nathanshaw/Parrot/README.md

# Parrot
Repo for housing everything Parrot Bot. A mechatronic creature which borrows rhythmic motifs from the sonic environment to playback on a host of actuators.
