nathanshaw/Parrot/pcb/eye_stocks/images/explorator_eye_stock_schematic.png

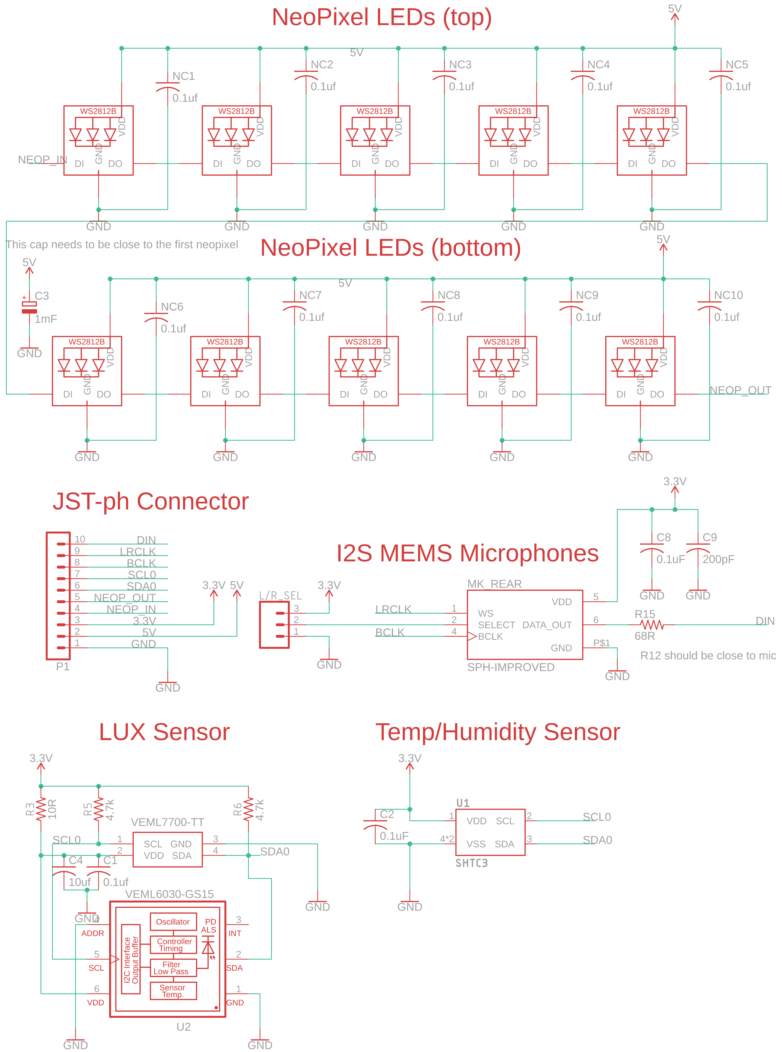
pcb/eye_stocks/images/explorator_eye_stock_schematic.png
