nathanshaw/Parrot/pcb/eye_stocks/images/explorator_eye_stock_v1_back_without_pour.png

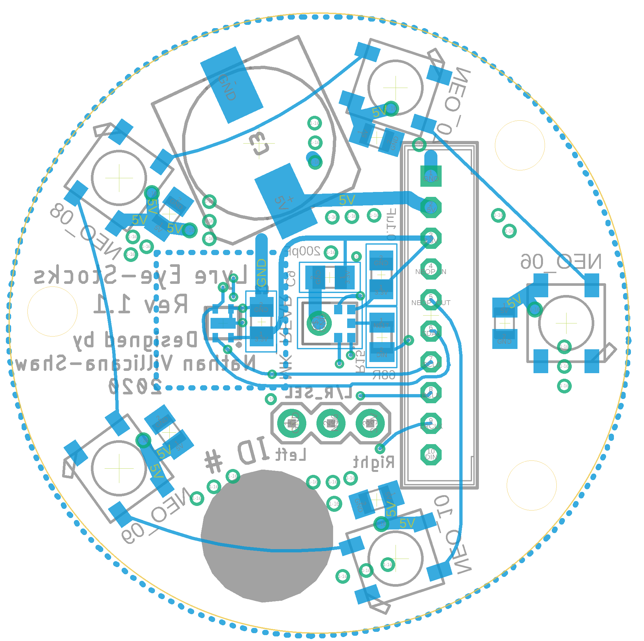
pcb/eye_stocks/images/explorator_eye_stock_v1_back_without_pour.png
