nathanshaw/Parrot/v1_images/parrot_back_with_pour.png

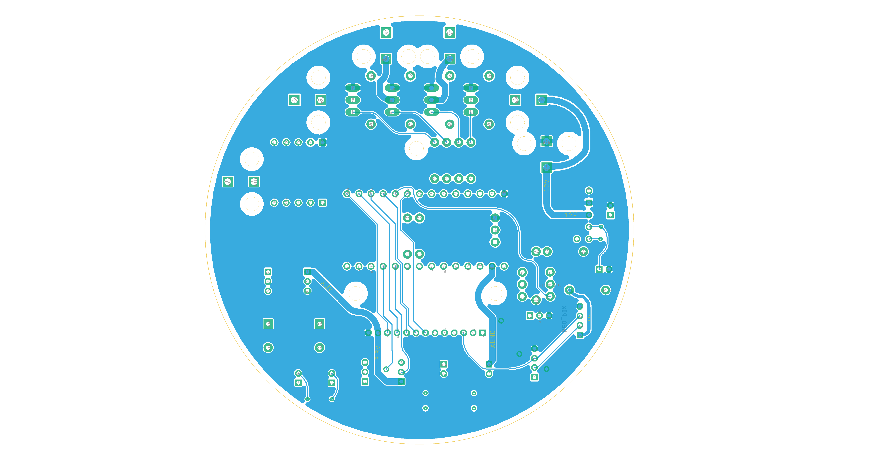
v1_images/parrot_back_with_pour.png
