nathanshaw/Parrot/v1_images/parrot_both_sides.png

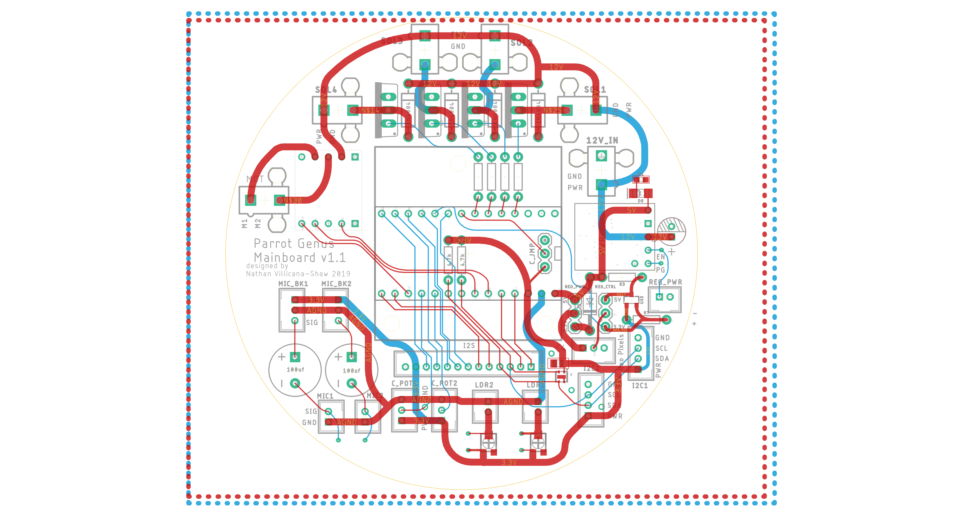
v1_images/parrot_both_sides.png
