nathanshaw/Parrot/legacy/Lyre_pictures/91280A702_MED-STRG ZINC-PLTD STL CAP SCREW - CLASS 8.8.STEP

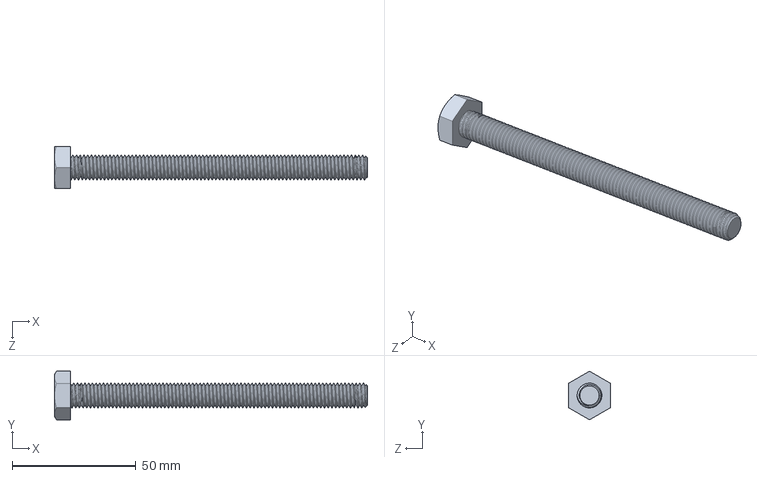
[picture p9: CAD file, 2020-02-04, an earlier design]
legacy/Lyre_pictures/91280A702_MED-STRG ZINC-PLTD STL CAP SCREW - CLASS 8.8.STEP
126.4 x 19.6 x 17.0 mm
