nathanshaw/Parrot/legacy/Lyre_pictures/94904A106_STAINLESS STEEL TEE NUT INSERT FOR WOOD.STEP

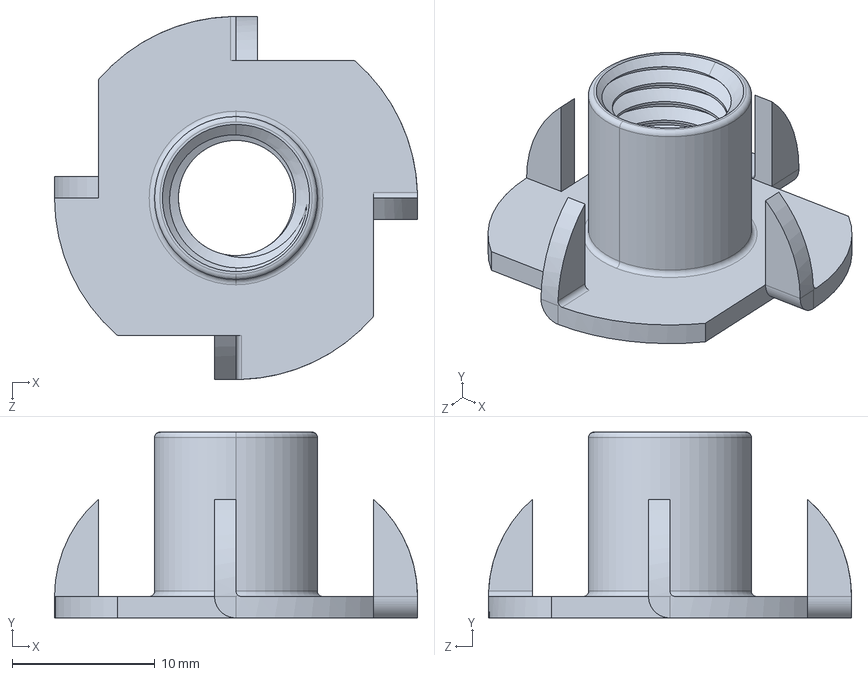
[picture p10: CAD file, 2020-02-04, an earlier design]
legacy/Lyre_pictures/94904A106_STAINLESS STEEL TEE NUT INSERT FOR WOOD.STEP
25.4 x 13.0 x 25.4 mm
