nathanshaw/Parrot/legacy/Lyre_pictures/90965A200_TYPE 316 STAINLESS STEEL FLAT WASHER.STEP

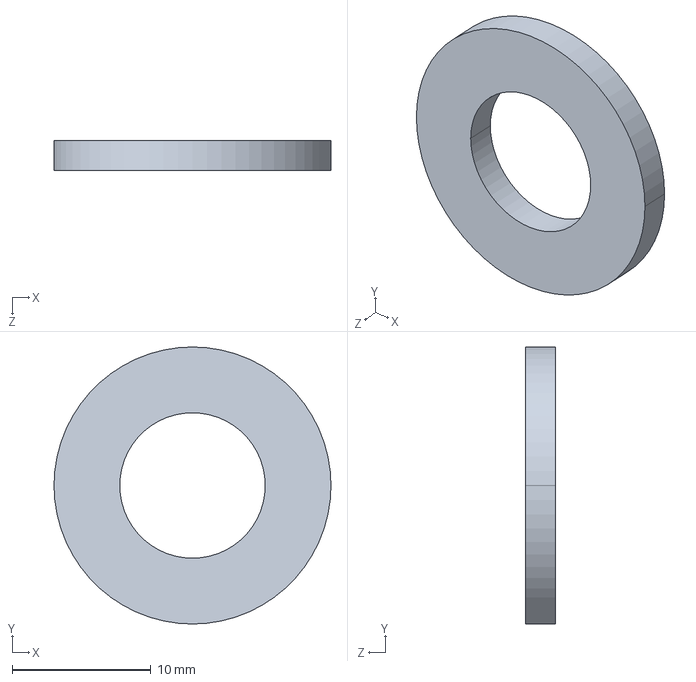
[picture p11: CAD file, 2020-02-04, an earlier design]
legacy/Lyre_pictures/90965A200_TYPE 316 STAINLESS STEEL FLAT WASHER.STEP
20.0 x 20.0 x 2.20 mm
