nathanshaw/Parrot/legacy/Lyre_pictures/Bowl Bot Order Request 2019_06_20 - Bowl Bot.pdf

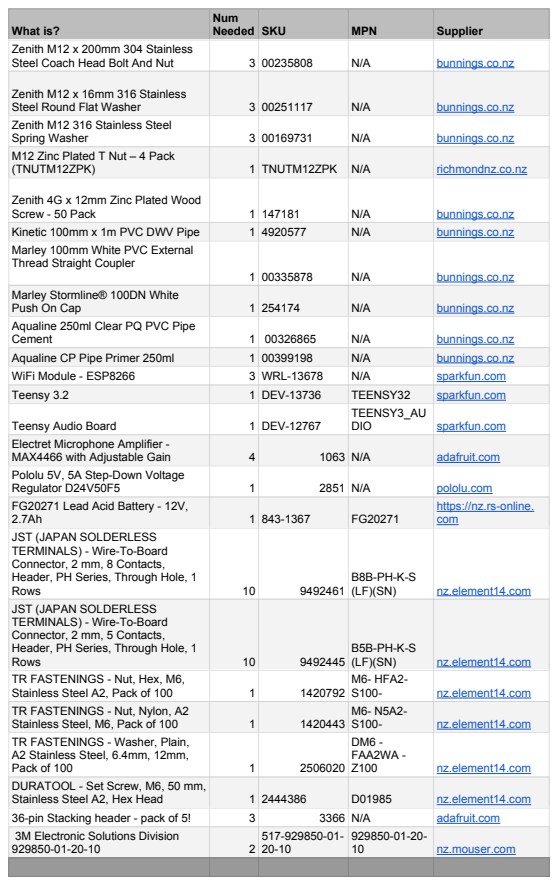
[picture p12: page 1]
What is?; Num; Needed SKU; MPN; Supplier; Zenith M12 x 200mm 304 Stainless; Steel Coach Head Bolt And Nut; bunnings.co.nz; Steel Round Flat Washer; Spring Washer; (TNUTM12ZPK); 1 TNUTM12ZPK; richmondnz.co.nz; Screw - 50 Pack; Kinetic 100mm x 1m PVC DWV Pipe; Push On Cap; Cement; Aqualine CP Pipe Primer 250ml; WiFi Module - ESP8266; 3 WRL-13678; sparkfun.com; Teensy 3.2; 1 DEV-13736; TEENSY32; Teensy Audio Board; 1 DEV-12767; TEENSY3_AU; DIO; MAX4466 with Adjustable Gain; adafruit.com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

Zenith M12 x 16mm 316 Stainless
Zenith M12 316 Stainless Steel
M12 Zinc Plated T Nut – 4 Pack

Zenith 4G x 12mm Zinc Plated Wood
Marley 100mm White PVC External
Thread Straight Coupler

Marley Stormline® 100DN White
Aqualine 250ml Clear PQ PVC Pipe

Electret Microphone Amplifier -
Pololu 5V, 5A Step-Down Voltage
FG20271 Lead Acid Battery - 12V,
JST (JAPAN SOLDERLESS
TERMINALS) - Wire-To-Board
Connector, 2 mm, 8 Contacts,
Header, PH Series, Through Hole, 1
Connector, 2 mm, 5 Contacts,
TR FASTENINGS - Nut, Hex, M6,
TR FASTENINGS - Nut, Nylon, A2
TR FASTENINGS - Washer, Plain,
A2 Stainless Steel, 6.4mm, 12mm,
DURATOOL - Set Screw, M6, 50 mm,
3M Electronic Solutions Division

https://nz.rs-online.
com (https://nz.rs-online.com)
