nathanshaw/Parrot/legacy/Lyre_pictures/Bowl-Bot v19 Drawing v2.pdf

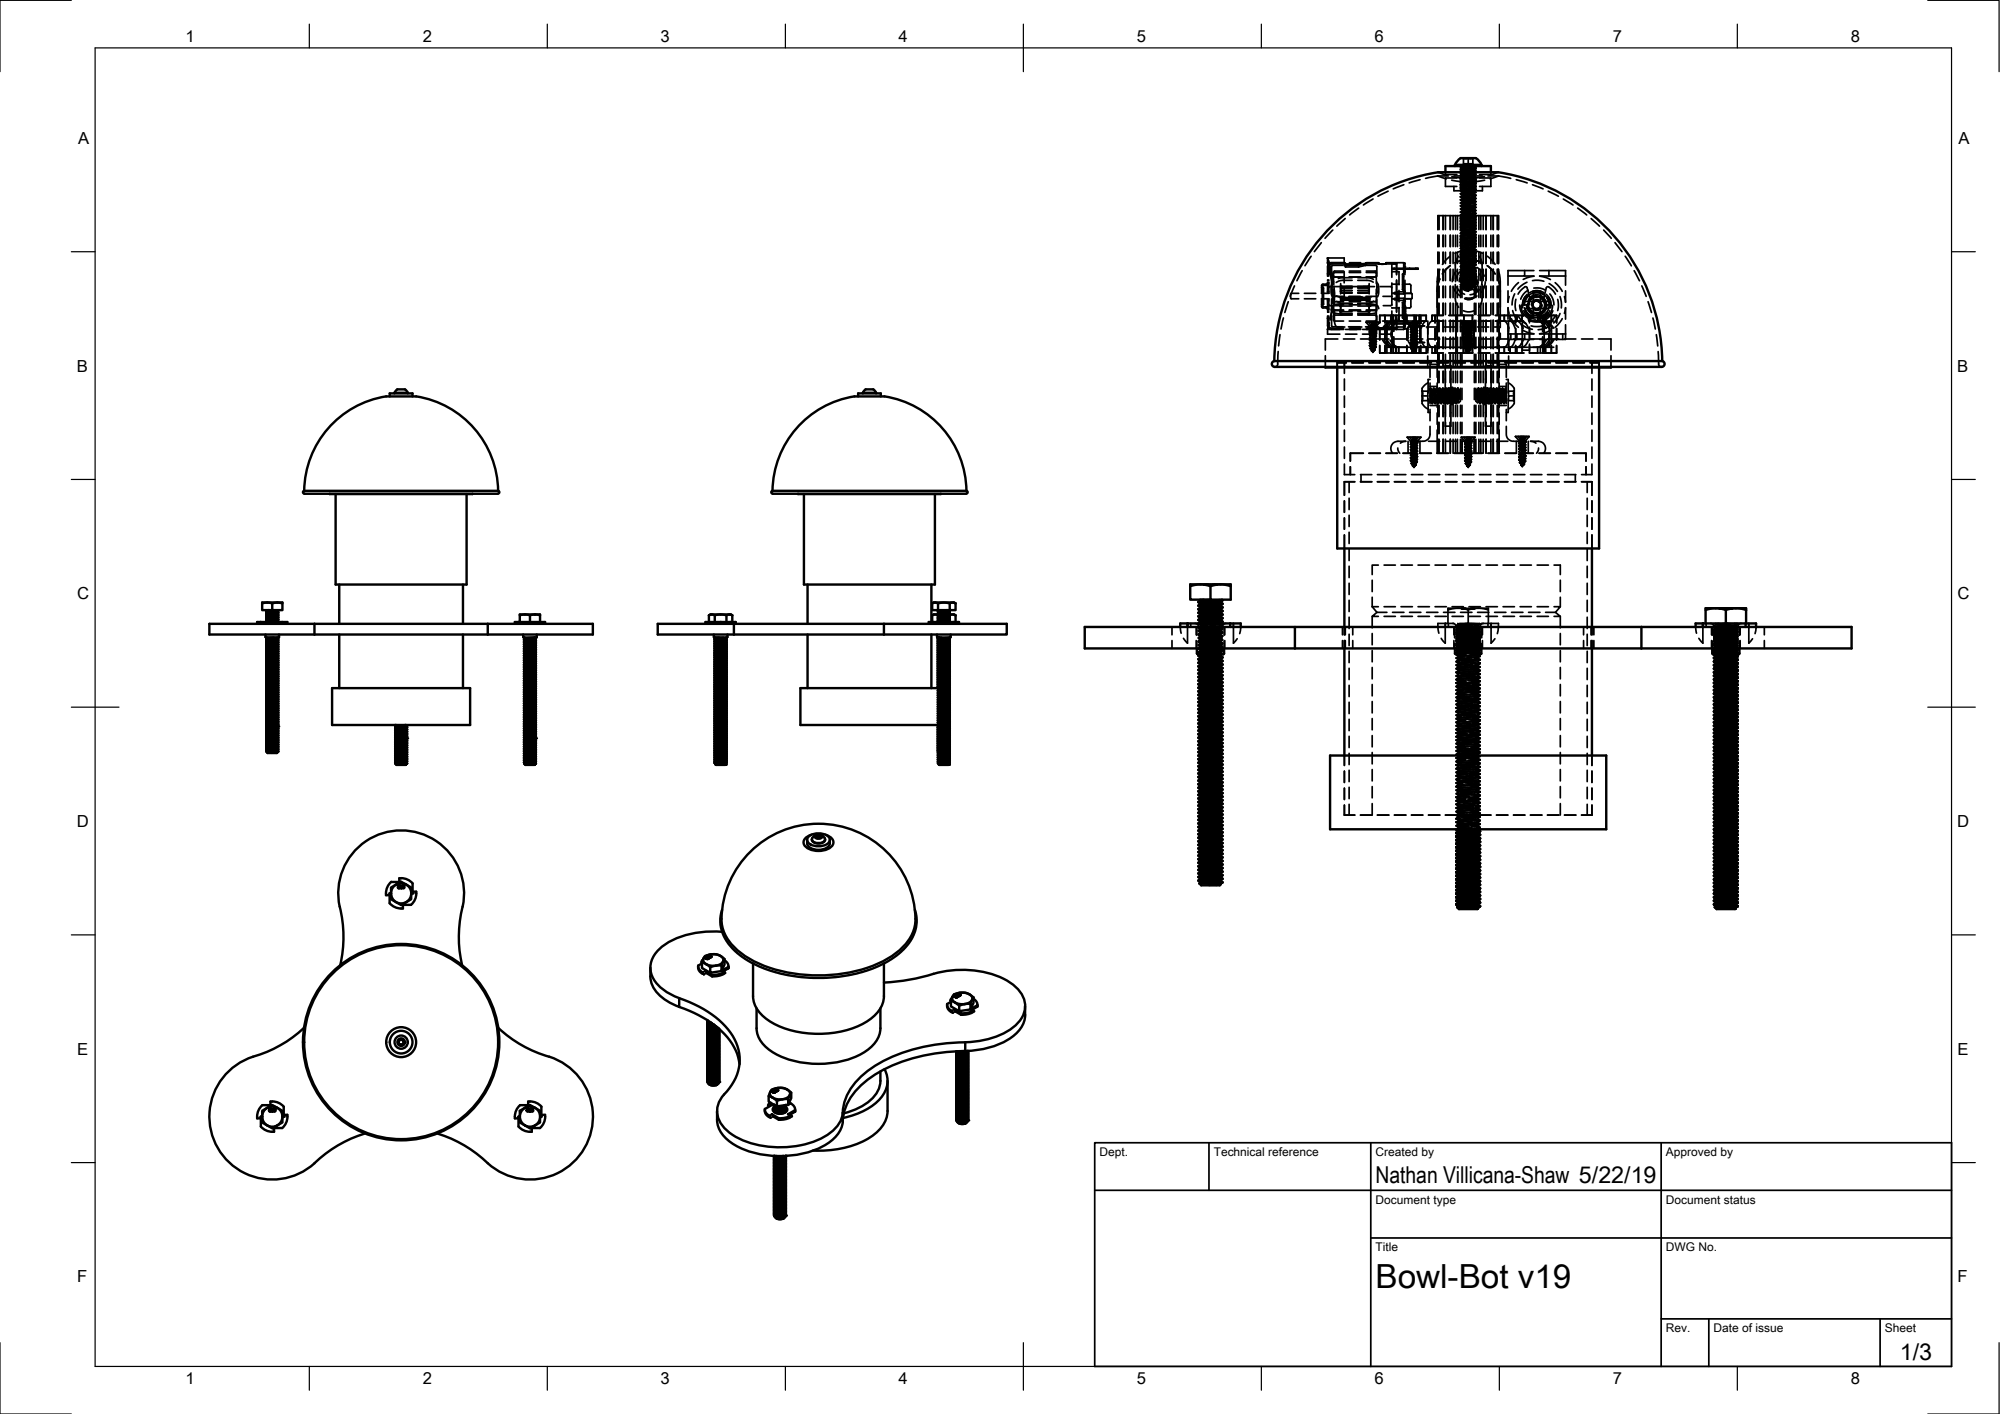
[picture p13: page 1]
Dept.; Technical reference; Created by; Approved by; Document type; Document status; Title; DWG No.; Rev.; Date of issue; Sheet; Bowl-Bot v19

Nathan Villicana-Shaw
