nathanshaw/Parrot/pcb/battery_pack/18500/18500_pack_v1.brd

## EAGLE design pcb/battery_pack/18500/18500_pack_v1.brd (2021-03-06)

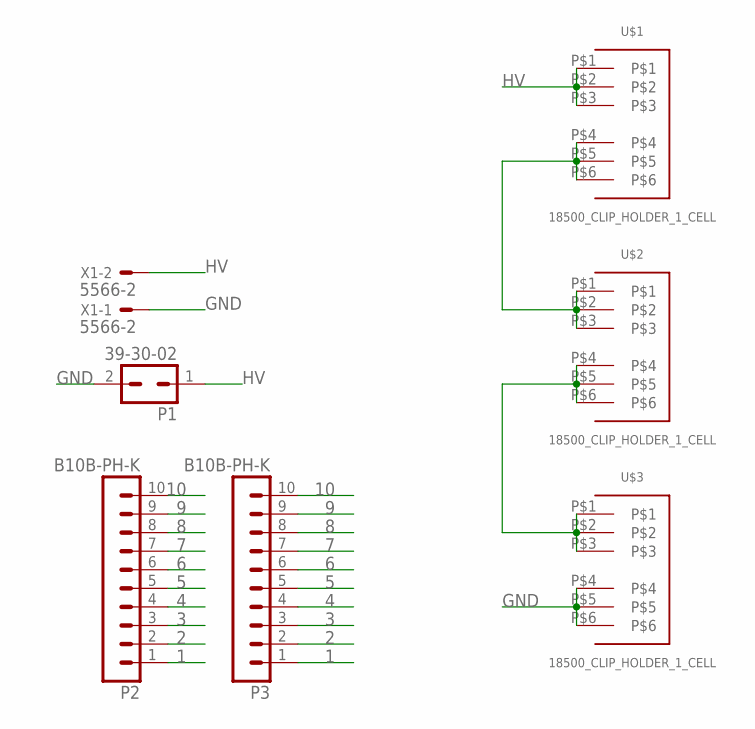
[picture p14: schematic 18500_pack_v1.sch]

Parts:
P1: 39-30-02; 39-30-?02?
P2, P3: B10B-PH-K
U$1, U$2, U$3: 18500_CLIP_HOLDER_1_CELL; 3PINBATTERY_CLIP_1_CELL_18500
X1: 5566-2

Connections:
1: P2.1, P3.1
2: P2.2, P3.2
3: P2.3, P3.3
4: P2.4, P3.4
5: P2.5, P3.5
6: P2.6, P3.6
7: P2.7, P3.7
8: P2.8, P3.8
9: P2.9, P3.9
10: P2.10, P3.10
GND: P1.2, U$3.P$4, U$3.P$5, U$3.P$6, X1.1
HV: P1.1, U$1.P$1, U$1.P$2, U$1.P$3, X1.2
unnamed: U$1.P$4, U$1.P$5, U$1.P$6, U$2.P$1, U$2.P$2, U$2.P$3
unnamed: U$2.P$4, U$2.P$5, U$2.P$6, U$3.P$1, U$3.P$2, U$3.P$3

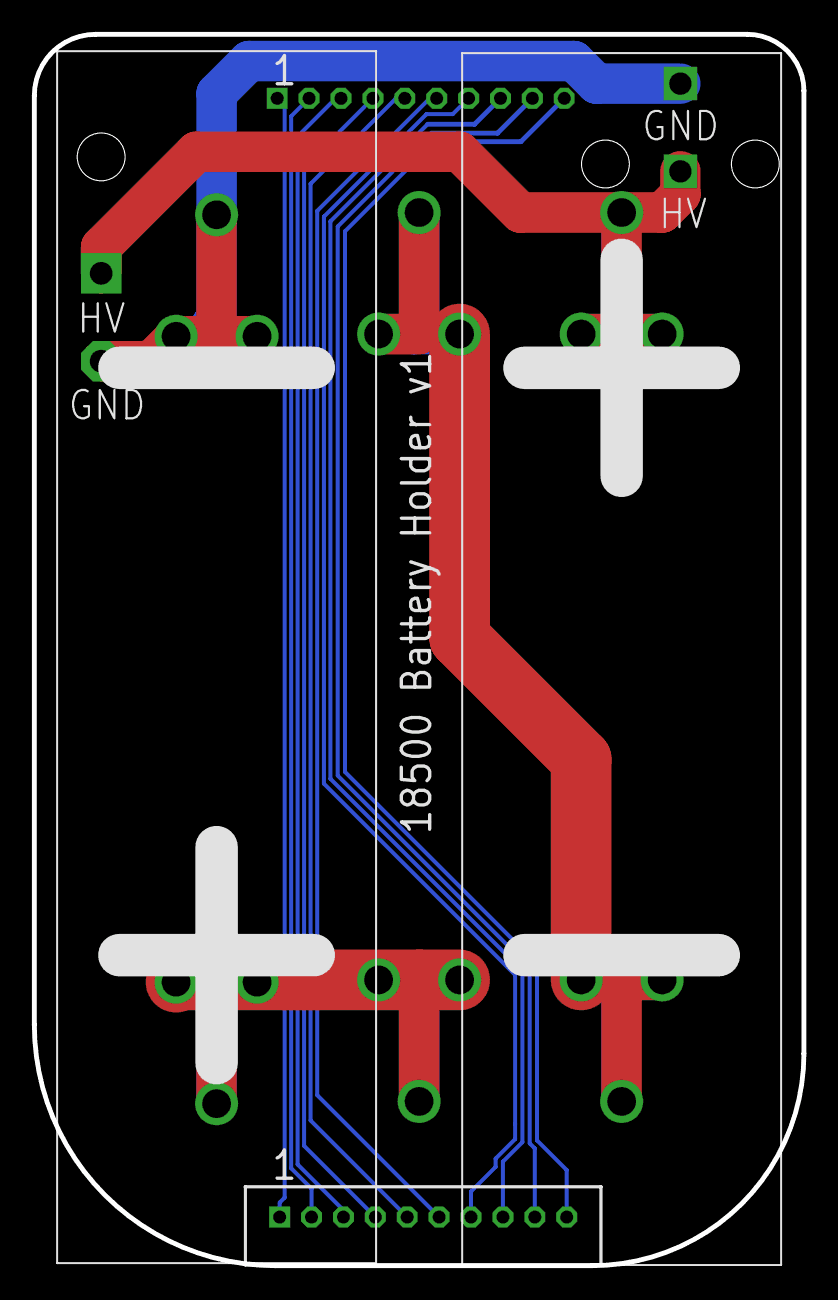
[picture p15: board 18500_pack_v1.brd from above]

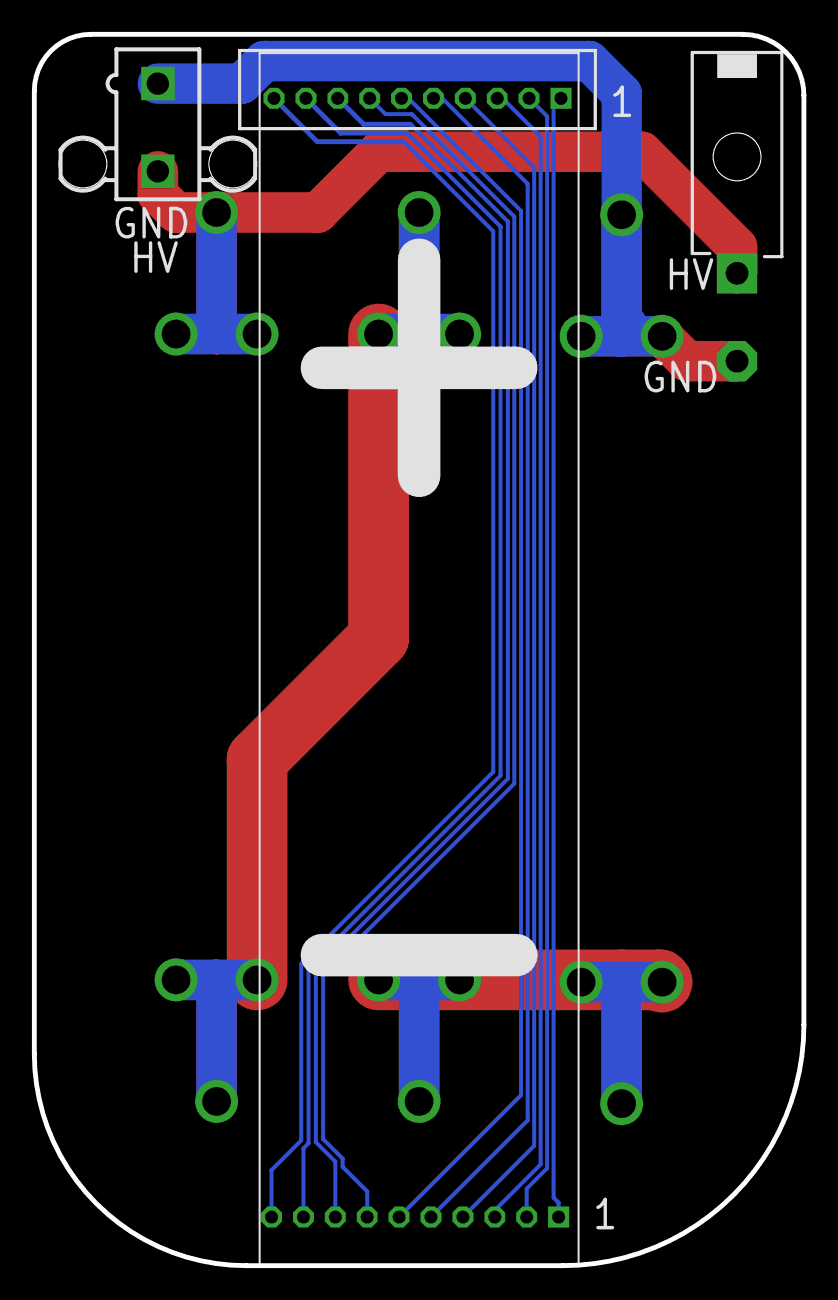
[picture p16: board 18500_pack_v1.brd from below]

Board: 2 copper layers, 48.3 x 77.2 mm, 7 parts (4 on the bottom side), 14 nets.
