nathanshaw/Parrot/pcb/v1/lyre_v1.brd

## EAGLE design pcb/v1/lyre_v1.brd (2021-03-06, an earlier design)

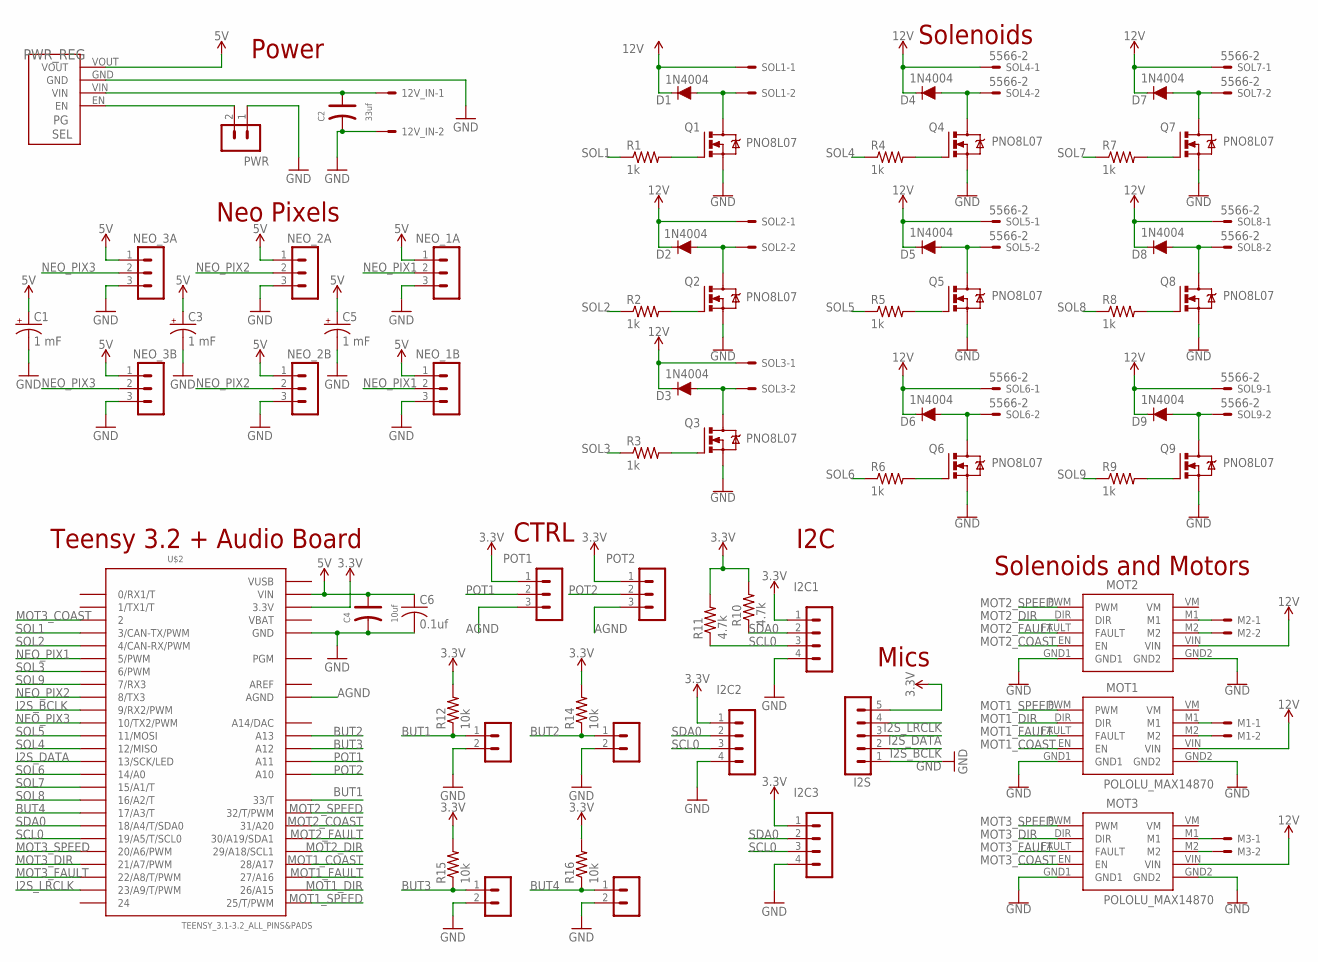
[picture p17: schematic lyre_v1.sch]

Parts:
12V_IN: 5566-2
BUT1, BUT2, BUT3, BUT4: B2B-PH-K
C1, C3, C5: 1 mF; UD-10X10_NICHICON
C2: 33uf; PC-D5.3MM
C4: 10uf; PC-D5.3MM
C6: 0.1uf; C2012
D1, D2, D3, D4, D5, D6, D7, D8, D9: 1N4004; DIOAD1138W86L465D235B
I2C1, I2C2, I2C3: B4B-PH-K
I2S: B5B-PH-K
M1, M2, M3: 5566-2
MOT1, MOT2, MOT3: POLOLU_MAX14870
NEO_1A, NEO_1B, NEO_2A, NEO_2B, NEO_3A, NEO_3B: B3B-PH-K
POT1, POT2: B3B-PH-K
PWR: B2B-PH-K
PWR_REG: S9V11F5S6CMA_MISSINIG_PINS; S9V11F3S5CMA_MISSING_PINS
Q1, Q2, Q3, Q4, Q5, Q6, Q7, Q8, Q9: PNO8L07; TO220BV
R1, R2, R3, R4, R5, R6, R7, R8, R9: 1k; R0805
R10, R11: 4.7k; R0805
R12, R14, R15, R16: 10k; R0805
SOL1, SOL2, SOL3, SOL4, SOL5, SOL6, SOL7, SOL8, SOL9: 5566-2
U$2: TEENSY_3.1-3.2_ALL_PINS&PADS; TEENSY_3.0-3.2_ALL_PINS_&_PADS

Connections:
3.3V: I2C1.1, I2C2.1, I2C3.1, I2S.5, POT1.1, POT2.1, R10.2, R11.2, R12.2, R14.2, R15.2, R16.2, U$2.3.3V, U$2.3.3V1 (3.3V), U$2.3.3V2 (3.3V)
5V: C1.+, C3.+, C4.+, C5.+, C6.1, NEO_1A.1, NEO_1B.1, NEO_2A.1, NEO_2B.1, NEO_3A.1, NEO_3B.1, PWR_REG.VOUT, U$2.VIN
12V: 12V_IN.1, C2.+, D1.2 (C), D2.2 (C), D3.2 (C), D4.2 (C), D5.2 (C), D6.2 (C), D7.2 (C), D8.2 (C), D9.2 (C), MOT1.VIN, MOT2.VIN, MOT3.VIN, PWR_REG.VIN, SOL1.1, SOL2.1, SOL3.1, SOL4.1, SOL5.1, SOL6.1, SOL7.1, SOL8.1, SOL9.1
AGND: POT1.3, POT2.3, U$2.AGND
AREF: U$2.AREF
BUT1: BUT1.1, R12.1, U$2.33 (33/T)
BUT2: BUT2.1, R14.1, U$2.A13
BUT3: BUT3.1, R15.1, U$2.A12
BUT4: BUT4.1, R16.1, U$2.17/A3 (17/A3/T)
GND: 12V_IN.2, BUT1.2, BUT2.2, BUT3.2, BUT4.2, C1.-, C2.-, C3.-, C4.-, C5.-, C6.2, I2C1.4, I2C2.4, I2C3.4, I2S.1, MOT1.GND1, MOT1.GND2, MOT2.GND1, MOT2.GND2, MOT3.GND1, MOT3.GND2, NEO_1A.3, NEO_1B.3, NEO_2A.3, NEO_2B.3, NEO_3A.3, NEO_3B.3, PWR.1, PWR_REG.GND, Q1.S, Q2.S, Q3.S, Q4.S, Q5.S, Q6.S, Q7.S, Q8.S, Q9.S, U$2.GND, U$2.GND1 (GND), U$2.GND2 (GND)
I2S_BCLK: I2S.2, U$2.9 (9/RX2/PWM)
I2S_DATA: I2S.3, U$2.13 (13/SCK/LED)
I2S_LRCLK: I2S.4, U$2.23/A9 (23/A9/T/PWM)
MOT1_COAST: MOT1.EN, U$2.28 (28/A17)
MOT1_DIR: MOT1.DIR, U$2.26 (26/A15)
MOT1_FAULT: MOT1.FAULT, U$2.27 (27/A16)
MOT1_SPEED: MOT1.PWM, U$2.25 (25/T/PWM)
MOT2_COAST: MOT2.EN, U$2.31 (31/A20)
MOT2_DIR: MOT2.DIR, U$2.29 (29/A18/SCL1)
MOT2_FAULT: MOT2.FAULT, U$2.30 (30/A19/SDA1)
MOT2_SPEED: MOT2.PWM, U$2.32 (32/T/PWM)
MOT3_COAST: MOT3.EN, U$2.2
MOT3_DIR: MOT3.DIR, U$2.21/A7 (21/A7/PWM)
MOT3_FAULT: MOT3.FAULT, U$2.22/A8 (22/A8/T/PWM)
MOT3_SPEED: MOT3.PWM, U$2.20/A6 (20/A6/PWM)
unnamed: Q5.G, R5.2
unnamed: D5.1 (A), Q5.D, SOL5.2
unnamed: M1.2, MOT1.M2
unnamed: Q6.G, R6.2
unnamed: Q2.G, R2.2
unnamed: D6.1 (A), Q6.D, SOL6.2
unnamed: D2.1 (A), Q2.D, SOL2.2
unnamed: M1.1, MOT1.M1
unnamed: PWR.2, PWR_REG.EN
unnamed: Q3.G, R3.2
unnamed: D3.1 (A), Q3.D, SOL3.2
unnamed: Q4.G, R4.2
unnamed: D4.1 (A), Q4.D, SOL4.2
unnamed: M3.2, MOT3.M2
unnamed: M3.1, MOT3.M1
unnamed: Q7.G, R7.2
unnamed: D7.1 (A), Q7.D, SOL7.2
unnamed: Q8.G, R8.2
unnamed: D8.1 (A), Q8.D, SOL8.2
unnamed: Q9.G, R9.2
unnamed: D9.1 (A), Q9.D, SOL9.2
unnamed: Q1.G, R1.2
unnamed: D1.1 (A), Q1.D, SOL1.2
unnamed: M2.2, MOT2.M2
unnamed: M2.1, MOT2.M1
NEO_PIX1: NEO_1A.2, NEO_1B.2, U$2.5 (5/PWM)
NEO_PIX2: NEO_2A.2, NEO_2B.2, U$2.8 (8/TX3)
NEO_PIX3: NEO_3A.2, NEO_3B.2, U$2.10 (10/TX2/PWM)
POT1: POT1.2, U$2.A11
POT2: POT2.2, U$2.A10
SCL0: I2C1.3, I2C2.3, I2C3.3, R11.1, U$2.19/A5 (19/A5/T/SCL0)
SDA0: I2C1.2, I2C2.2, I2C3.2, R10.1, U$2.18/A4 (18/A4/T/SDA0)
SOL1: R1.1, U$2.3 (3/CAN-TX/PWM)
SOL2: R2.1, U$2.4 (4/CAN-RX/PWM)
SOL3: R3.1, U$2.6 (6/PWM)
SOL4: R4.1, U$2.12 (12/MISO)
SOL5: R5.1, U$2.11 (11/MOSI)
SOL6: R6.1, U$2.14/A0
SOL7: R7.1, U$2.15/A1 (15/A1/T)
SOL8: R8.1, U$2.16/A2 (16/A2/T)
SOL9: R9.1, U$2.7 (7/RX3)
VBAT: U$2.VBAT
VUSB: U$2.VUSB

Notes on the sheet:
Neo Pixels
I2C
Solenoids and Motors
Teensy 3.2 + Audio Board
Mics
Power
CTRL
Solenoids

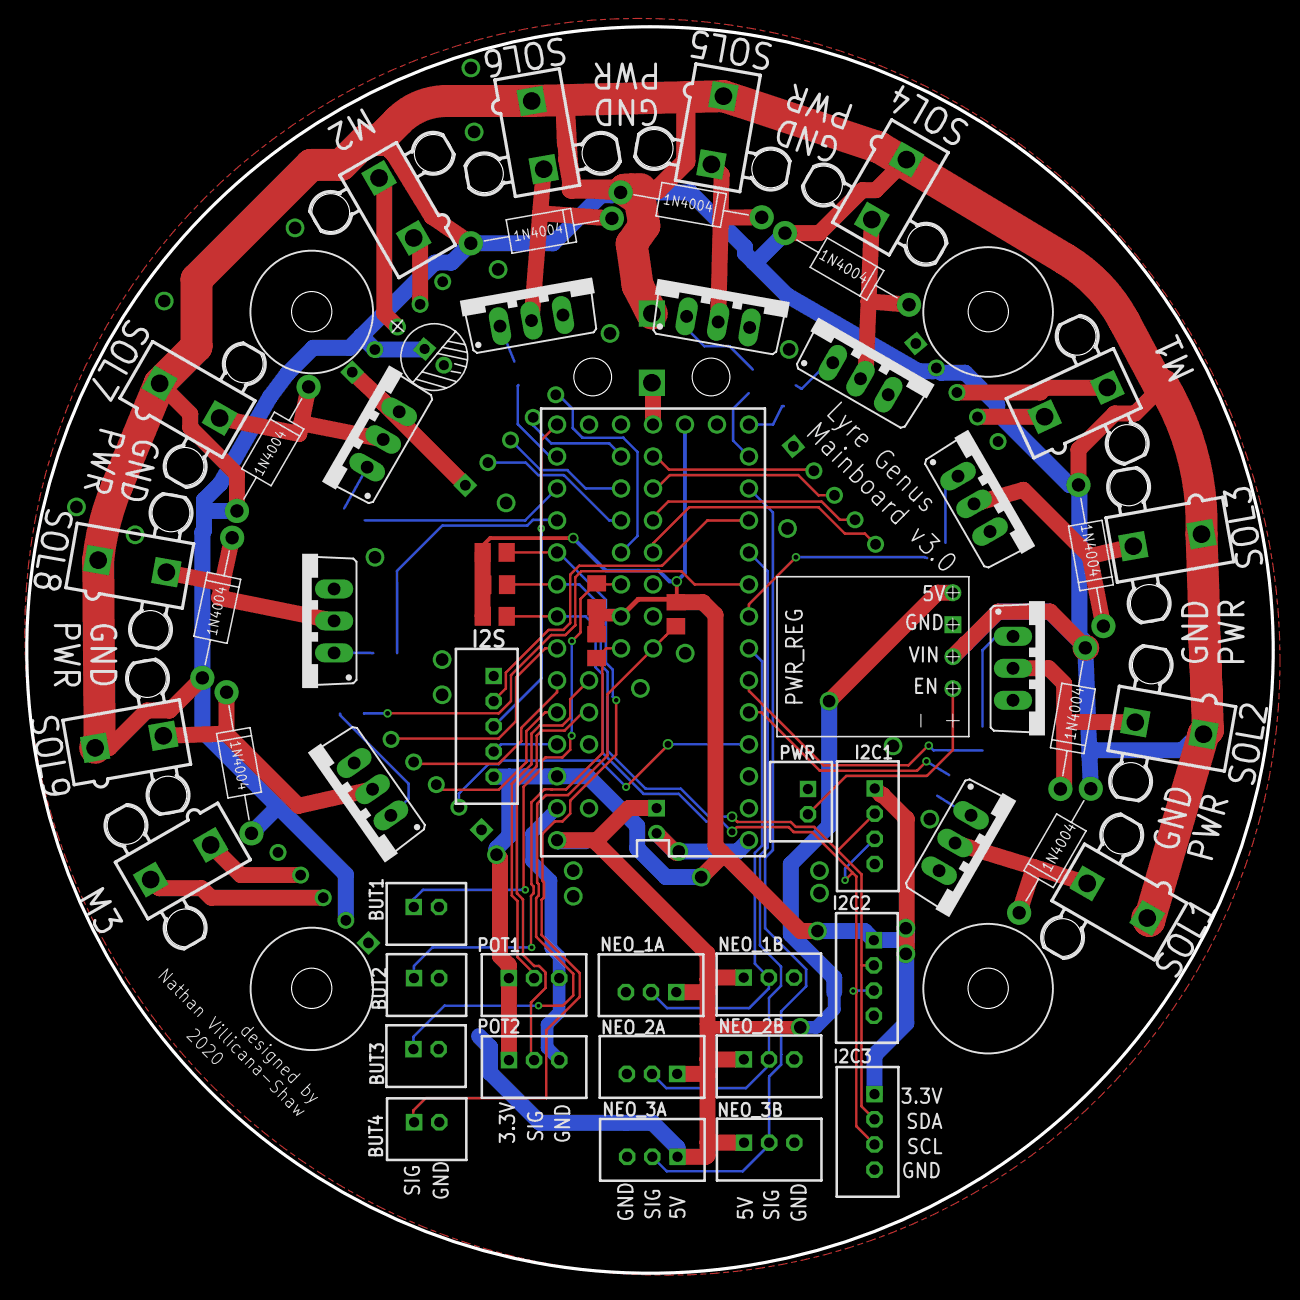
[picture p18: board lyre_v1.brd from above]

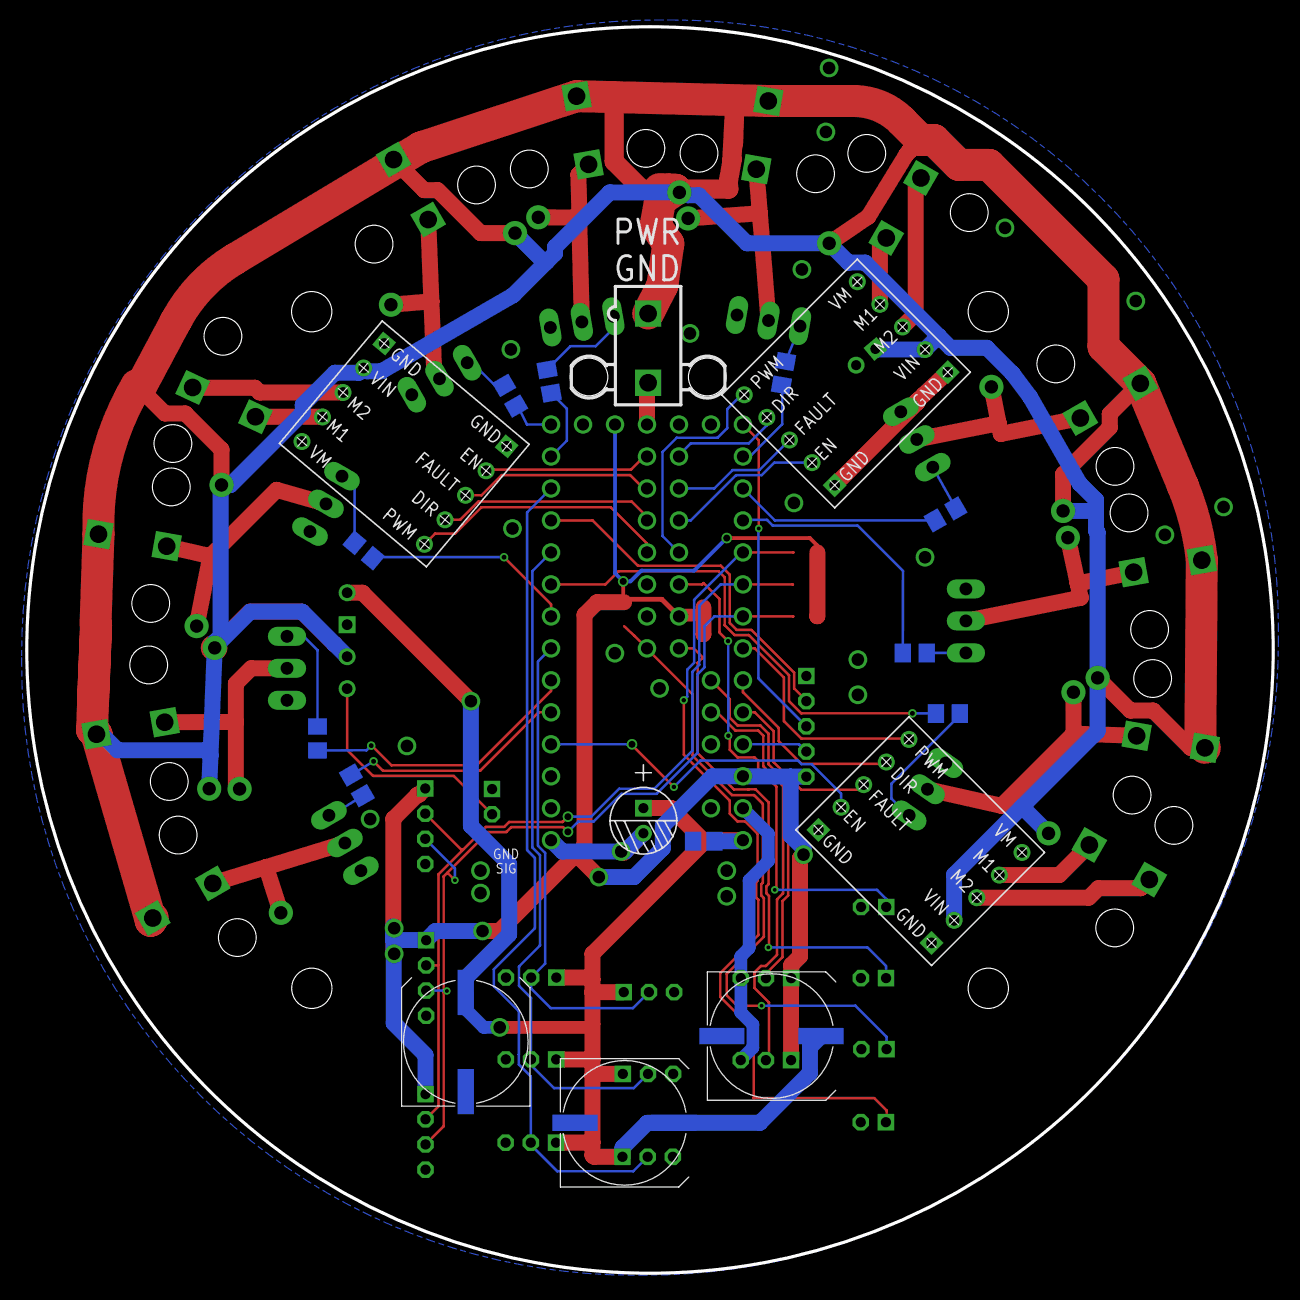
[picture p19: board lyre_v1.brd from below]

Board: 2 copper layers, 99.0 x 99.0 mm, 74 parts (18 on the bottom side), 65 nets.
