nathanshaw/Parrot/pcb/eye_stocks/lyre_eye_stocks_40mm_breakout.brd

## EAGLE design pcb/eye_stocks/lyre_eye_stocks_40mm_breakout.brd (2021-03-06)

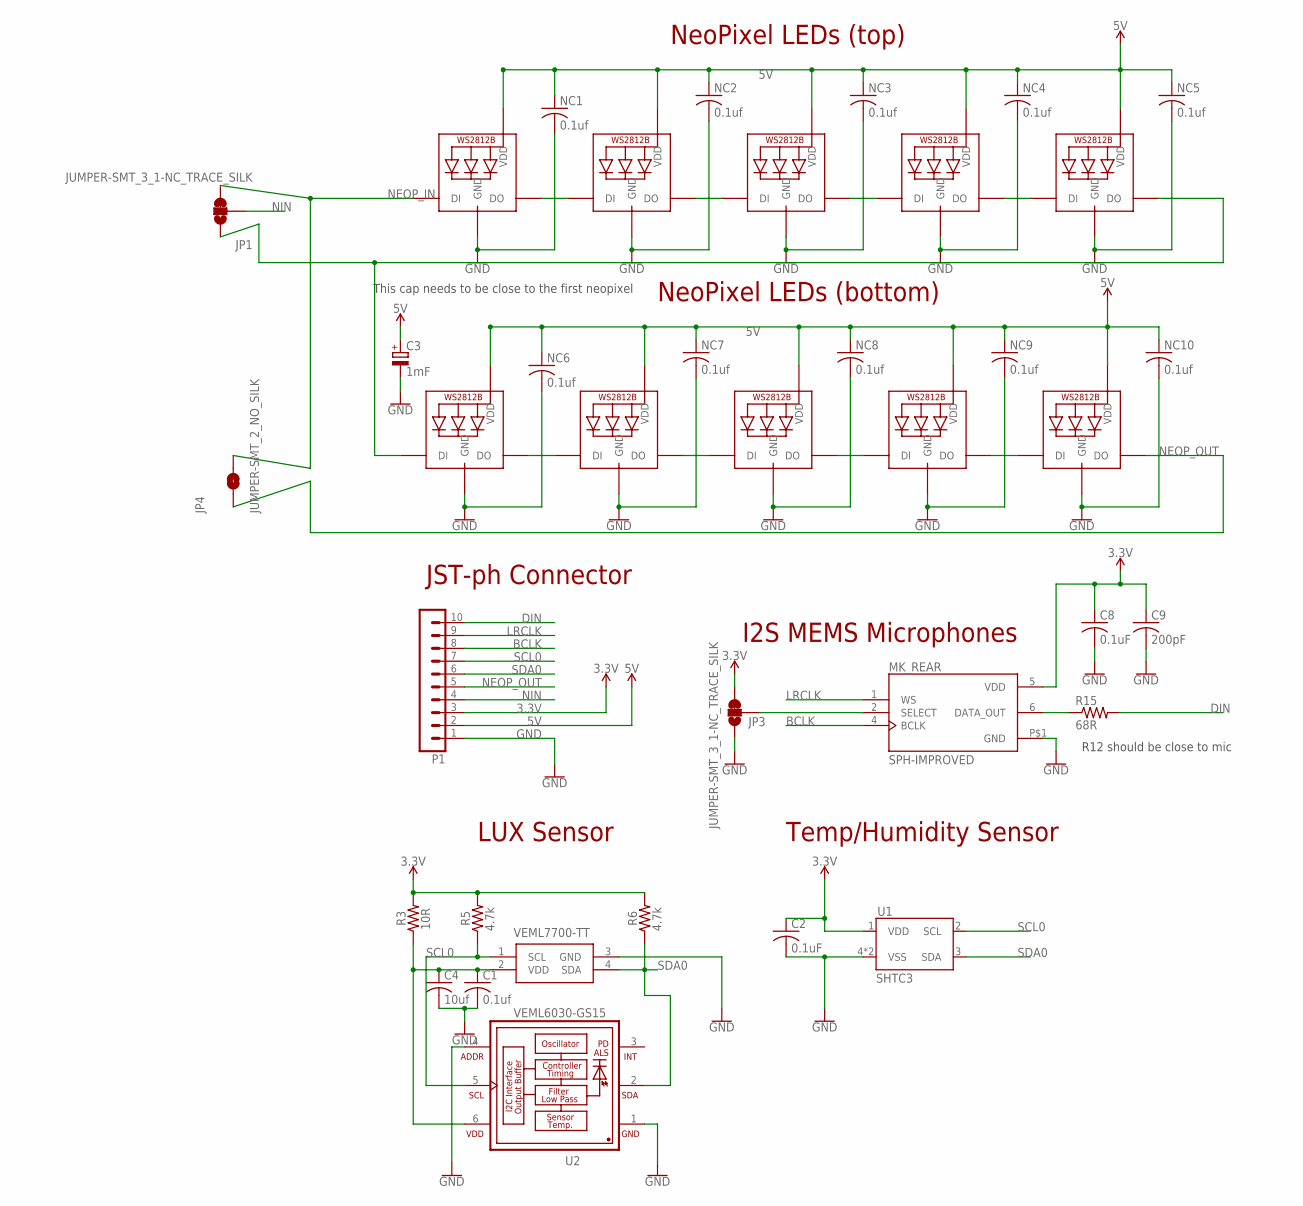
[picture p20: schematic lyre_eye_stocks_40mm_breakout.sch]

Parts:
C1: 0.1uf; C0805
C2, C8: 0.1uF; C0805
C3: 1mF; 153CLV-1012
C4: 10uf; C0805
C9: 200pF; C0805
JP1, JP3: JUMPER-SMT_3_1-NC_TRACE_SILK; SMT-JUMPER_3_1-NC_TRACE_SILK
JP4: JUMPER-SMT_2_NO_SILK; SMT-JUMPER_2_NO_SILK
MK_REAR: SPH-IMPROVED; MIC_SPH0645LM4H-B_LARGER_RING
NC1, NC2, NC3, NC4, NC5, NC6, NC7, NC8, NC9, NC10: 0.1uf; C0805
NEO_01, NEO_02, NEO_03, NEO_04, NEO_05, NEO_06, NEO_07, NEO_08, NEO_09, NEO_10: WS2812; WS2812B
P1: B10B-PH-K
R3: 10R; R0805
R5, R6: 4.7k; R0805
R15: 68R; R0805
U1: SHTC3
U2: VEML6030-GS15; VISHAY_VEML6030_2X2X0.87
VEML_F: VEML7700-TT; VEML7700

Connections:
3.3V: C2.1, C8.1, C9.1, JP3.3, MK_REAR.5 (VDD), P1.3, R3.2, R5.2, R6.2, U1.1 (VDD)
5V: C3.+, NC1.1, NC2.1, NC3.1, NC4.1, NC5.1, NC6.1, NC7.1, NC8.1, NC9.1, NC10.1, NEO_01.1-VDD (VDD), NEO_02.1-VDD (VDD), NEO_03.1-VDD (VDD), NEO_04.1-VDD (VDD), NEO_05.1-VDD (VDD), NEO_06.1-VDD (VDD), NEO_07.1-VDD (VDD), NEO_08.1-VDD (VDD), NEO_09.1-VDD (VDD), NEO_10.1-VDD (VDD), P1.2
BCLK: MK_REAR.4 (BCLK), P1.8
DIN: P1.10, R15.2
GND: C1.2, C2.2, C3.-, C4.2, C8.2, C9.2, JP3.1, MK_REAR.P$1 (GND), NC1.2, NC2.2, NC3.2, NC4.2, NC5.2, NC6.2, NC7.2, NC8.2, NC9.2, NC10.2, NEO_01.3-GND (GND), NEO_02.3-GND (GND), NEO_03.3-GND (GND), NEO_04.3-GND (GND), NEO_05.3-GND (GND), NEO_06.3-GND (GND), NEO_07.3-GND (GND), NEO_08.3-GND (GND), NEO_09.3-GND (GND), NEO_10.3-GND (GND), P1.1, U1.4 (VSS), U1.5 (VSS), U2.1 (GND), U2.4 (ADDR), VEML_F.3 (GND)
LRCLK: MK_REAR.1 (WS), P1.9
unnamed: C1.1, C4.1, R3.1, U2.6 (VDD), VEML_F.2 (VDD)
unnamed: JP1.1, NEO_05.2-DOUT (DO), NEO_06.4-DIN (DI)
unnamed: NEO_02.2-DOUT (DO), NEO_03.4-DIN (DI)
unnamed: NEO_09.2-DOUT (DO), NEO_10.4-DIN (DI)
unnamed: JP3.2, MK_REAR.2 (SELECT)
unnamed: NEO_07.2-DOUT (DO), NEO_08.4-DIN (DI)
unnamed: NEO_04.2-DOUT (DO), NEO_05.4-DIN (DI)
unnamed: NEO_08.2-DOUT (DO), NEO_09.4-DIN (DI)
unnamed: NEO_03.2-DOUT (DO), NEO_04.4-DIN (DI)
unnamed: MK_REAR.6 (DATA_OUT), R15.1
NEOP_IN: JP1.3, JP4.2, NEO_01.4-DIN (DI)
NEOP_OUT: JP4.1, NEO_10.2-DOUT (DO), P1.5
NEO_P1: NEO_01.2-DOUT (DO), NEO_02.4-DIN (DI)
NEO_P2: NEO_06.2-DOUT (DO), NEO_07.4-DIN (DI)
NIN: JP1.2, P1.4
SCL0: P1.7, R5.1, U1.2 (SCL), U2.5 (SCL), VEML_F.1 (SCL)
SDA0: P1.6, R6.1, U1.3 (SDA), U2.2 (SDA), VEML_F.4 (SDA)

Notes on the sheet:
I2S MEMS Microphones
LUX Sensor
NeoPixel LEDs (top)
4.7k
R12 should be close to mic
10R
This cap needs to be close to the first neopixel
Temp/Humidity Sensor
NeoPixel LEDs (bottom)
JST-ph Connector

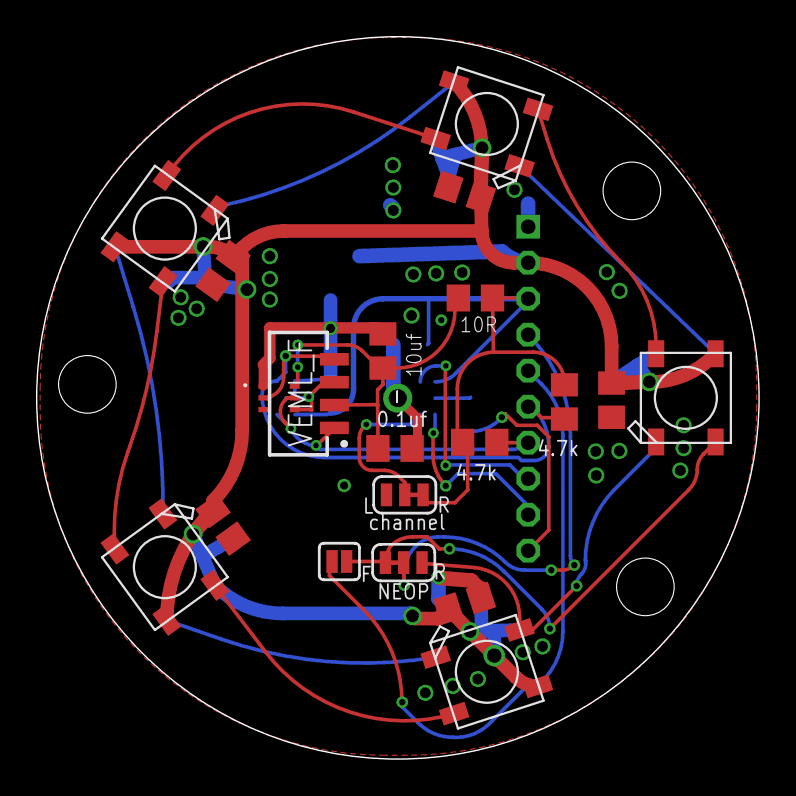
[picture p21: board lyre_eye_stocks_40mm_breakout.brd from above]

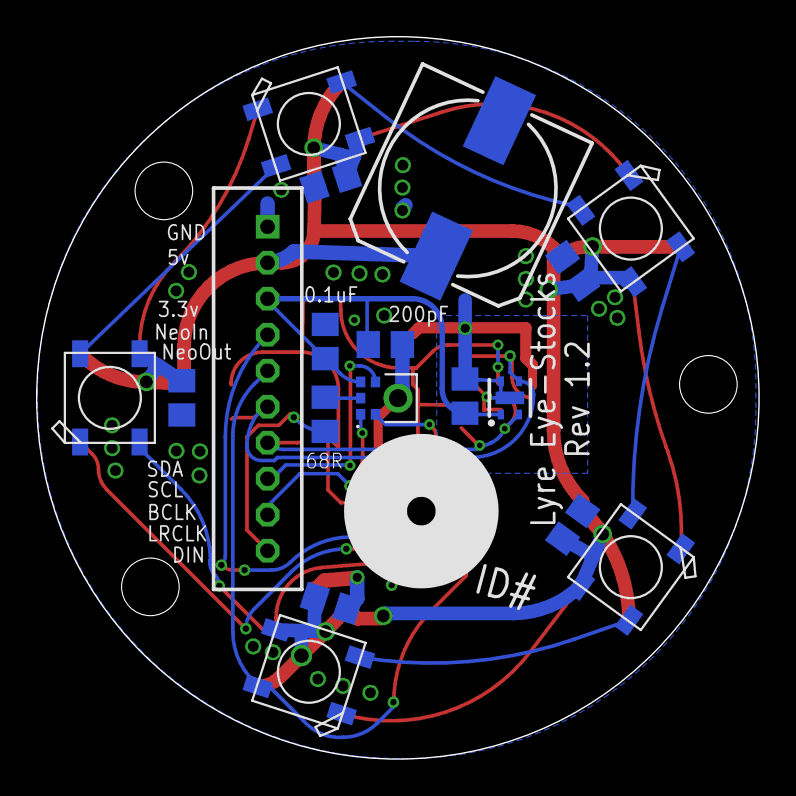
[picture p22: board lyre_eye_stocks_40mm_breakout.brd from below]

Board: 2 copper layers, 40.1 x 40.1 mm, 38 parts (18 on the bottom side), 23 nets.
