nathanshaw/Parrot/pcb/small_pcb_v1/small_pcb_explorator_58mm_lyre_v1_1.brd

## EAGLE design pcb/small_pcb_v1/small_pcb_explorator_58mm_lyre_v1_1.brd (2021-03-06)

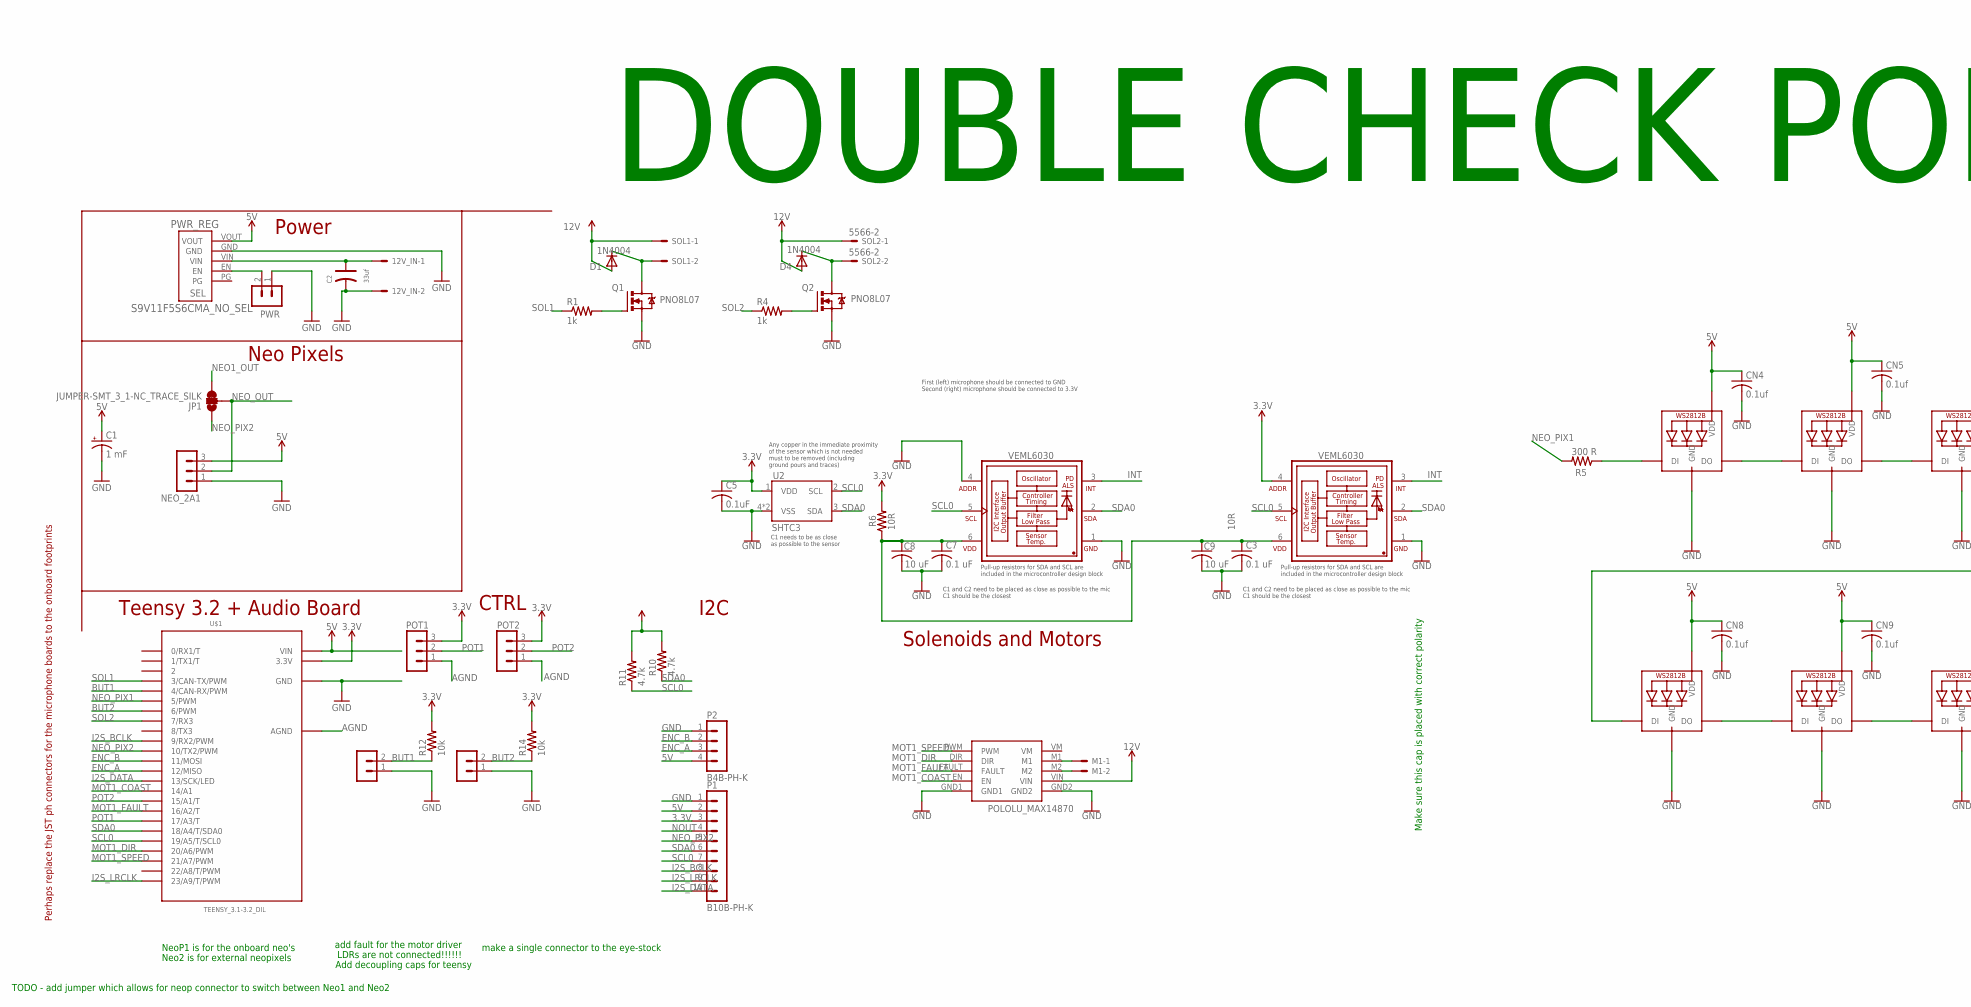
[picture p23: schematic small_pcb_explorator_58mm_lyre_v1_1.sch, part in row 1, column 1]

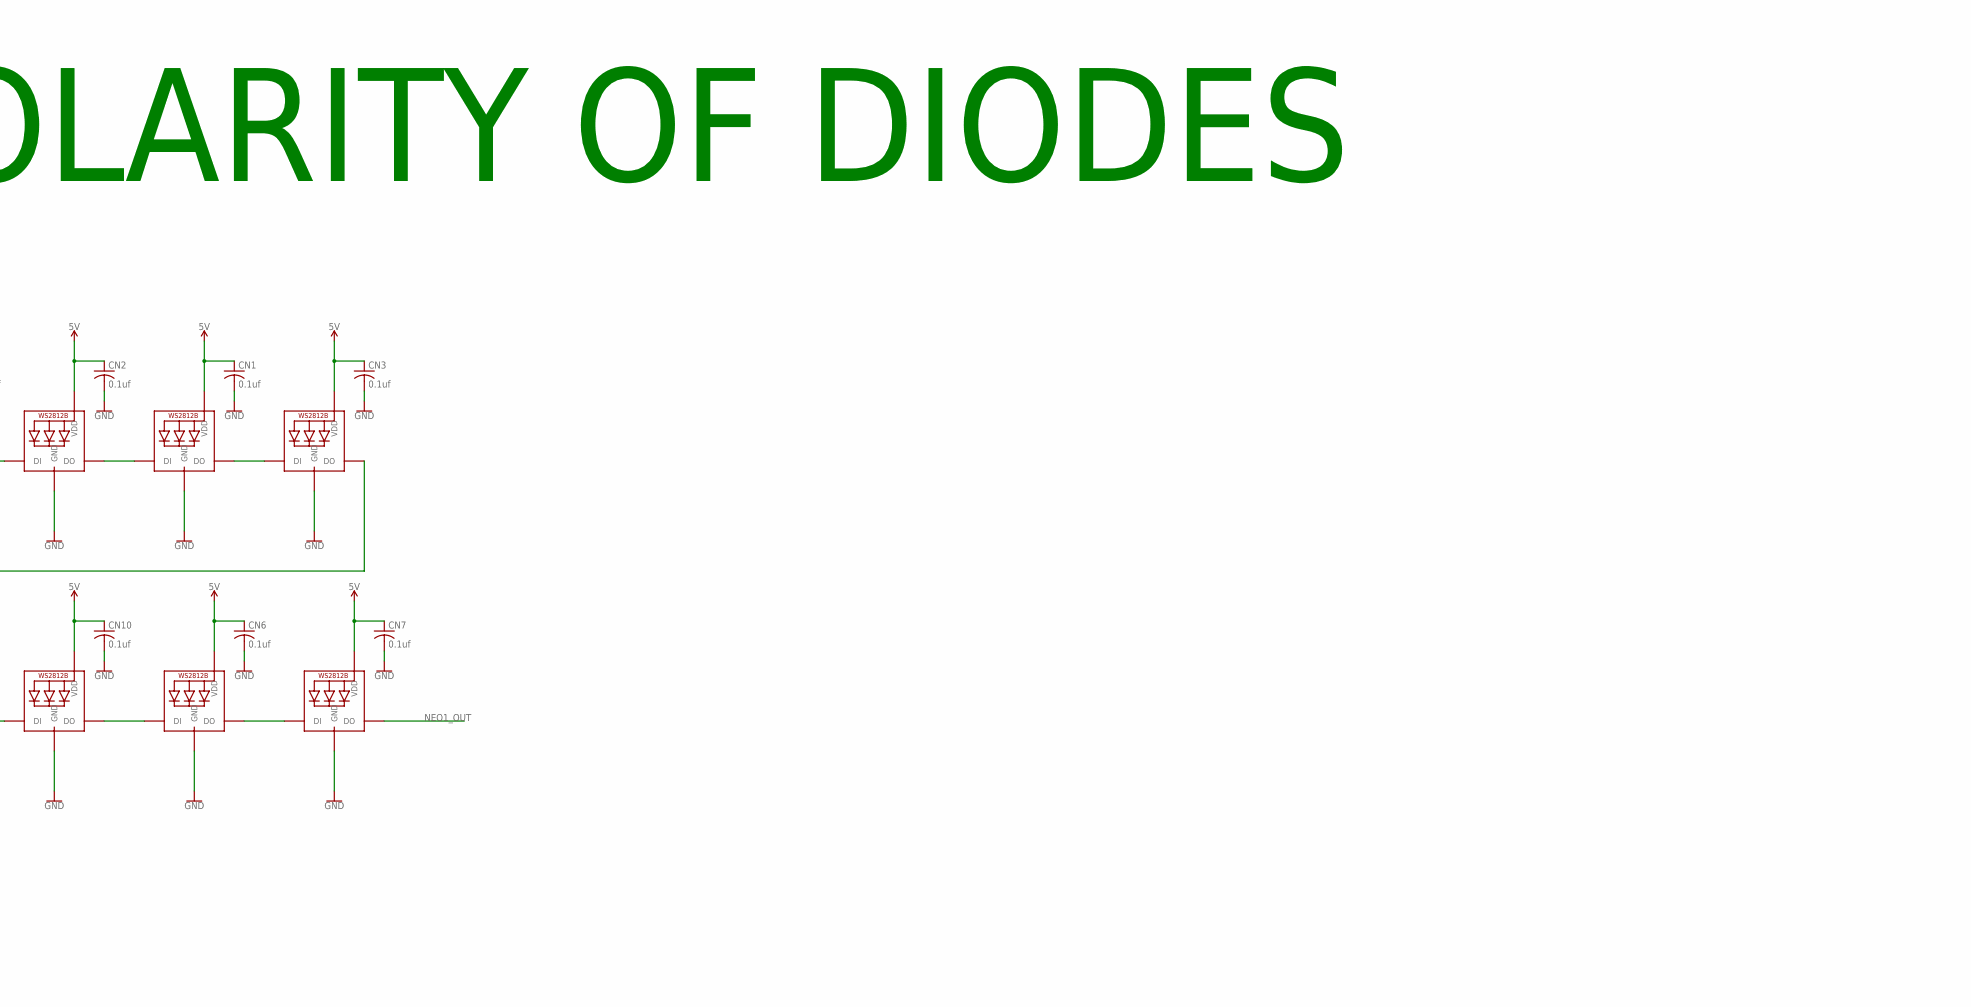
[picture p24: schematic small_pcb_explorator_58mm_lyre_v1_1.sch, part in row 1, column 2]

Parts:
12V_IN: 5566-2
BUT1, BUT2: B2B-PH-K
C1: 1 mF; UD-10X10_NICHICON
C2: 33uf; PC-D5.3MM
C3, C7: 0.1 uF; C0805
C5: 0.1uF; C0805
C8, C9: 10 uF; C0805
CN1, CN2, CN3, CN4, CN5, CN6, CN7, CN8, CN9, CN10: 0.1uf; C0805K
D1, D4: 1N4004; DIODE_DO35-7
JP1: JUMPER-SMT_3_1-NC_TRACE_SILK; SMT-JUMPER_3_1-NC_TRACE_SILK
M1: 5566-2
MOT1: POLOLU_MAX14870
NEO1, NEO2, NEO3, NEO4, NEO5, NEO6, NEO7, NEO8, NEO9, NEO10: WS2812B5050; WS2812B
NEO_2A1: B3B-PH-K
P1: B10B-PH-K
P2: B4B-PH-K
POT1, POT2: B3B-PH-K
PWR: B2B-PH-K
PWR_REG: S9V11F5S6CMA_NO_SEL; S9V11F3S5CMA_NO_SEL
Q1, Q2: PNO8L07; TO220BV
R1, R4: 1k; R0805
R5: 300 R; R0805
R6: 10 R; R0805
R10, R11: 4.7k; R0805
R12, R14: 10k; R0805
SOL1, SOL2: 5566-2
U2: SHTC3
U$1: TEENSY_3.1-3.2_DIL; TEENSY_3.0-3.2&LC_DIL
VMEL1, VMEL2: VEML6030; VISHAY_VEML6030_2X2X0.87

Connections:
3.3V: C5.1, P1.3, POT1.3, POT2.3, R6.2, R10.2, R11.2, R12.2, R14.2, U2.1 (VDD), U$1.3.3V, VMEL2.4 (ADDR)
5V: C1.+, CN1.1, CN2.1, CN3.1, CN4.1, CN5.1, CN6.1, CN7.1, CN8.1, CN9.1, CN10.1, NEO1.1-VDD (VDD), NEO2.1-VDD (VDD), NEO3.1-VDD (VDD), NEO4.1-VDD (VDD), NEO5.1-VDD (VDD), NEO6.1-VDD (VDD), NEO7.1-VDD (VDD), NEO8.1-VDD (VDD), NEO9.1-VDD (VDD), NEO10.1-VDD (VDD), NEO_2A1.3, P1.2, P2.4, PWR_REG.VOUT, U$1.VIN
12V: 12V_IN.1, C2.+, D1.A (C), D4.A (C), MOT1.VIN, PWR_REG.VIN, SOL1.1, SOL2.1
AGND: POT1.1, POT2.1, U$1.AGND
BUT1: BUT1.2, R12.1, U$1.4 (4/CAN-RX/PWM)
BUT2: BUT2.2, R14.1, U$1.6 (6/PWM)
ENC_A: P2.3, U$1.12 (12/MISO)
ENC_B: P2.2, U$1.11 (11/MOSI)
GND: 12V_IN.2, BUT1.1, BUT2.1, C1.-, C2.-, C3.2, C5.2, C7.2, C8.2, C9.2, CN1.2, CN2.2, CN3.2, CN4.2, CN5.2, CN6.2, CN7.2, CN8.2, CN9.2, CN10.2, MOT1.GND1, MOT1.GND2, NEO1.3-GND (GND), NEO2.3-GND (GND), NEO3.3-GND (GND), NEO4.3-GND (GND), NEO5.3-GND (GND), NEO6.3-GND (GND), NEO7.3-GND (GND), NEO8.3-GND (GND), NEO9.3-GND (GND), NEO10.3-GND (GND), NEO_2A1.1, P1.1, P2.1, PWR.1, PWR_REG.GND, Q1.S, Q2.S, U2.4 (VSS), U2.5 (VSS), U$1.GND, VMEL1.1 (GND), VMEL1.4 (ADDR), VMEL2.1 (GND)
I2S_BCLK: P1.8, U$1.9 (9/RX2/PWM)
I2S_DATA: P1.10, U$1.13 (13/SCK/LED)
I2S_LRCLK: P1.9, U$1.23/A9 (23/A9/T/PWM)
INT: VMEL1.3 (INT), VMEL2.3 (INT)
MOT1_COAST: MOT1.EN, U$1.14/A0 (14/A1)
MOT1_DIR: MOT1.DIR, U$1.20/A6 (20/A6/PWM)
MOT1_FAULT: MOT1.FAULT, U$1.16/A2 (16/A2/T)
MOT1_SPEED: MOT1.PWM, U$1.21/A7 (21/A7/PWM)
unnamed: NEO4.2-DOUT (DO), NEO5.4-DIN (DI)
unnamed: NEO1.4-DIN (DI), NEO5.2-DOUT (DO)
unnamed: M1.2, MOT1.M2
unnamed: NEO1.2-DOUT (DO), NEO2.4-DIN (DI)
unnamed: NEO2.2-DOUT (DO), NEO3.4-DIN (DI)
unnamed: NEO3.2-DOUT (DO), NEO8.4-DIN (DI)
unnamed: C3.1, C7.1, C8.1, C9.1, R6.1, VMEL1.6 (VDD), VMEL2.6 (VDD)
unnamed: NEO4.4-DIN (DI), R5.1
unnamed: M1.1, MOT1.M1
unnamed: PWR.2, PWR_REG.EN
unnamed: NEO8.2-DOUT (DO), NEO9.4-DIN (DI)
unnamed: NEO9.2-DOUT (DO), NEO10.4-DIN (DI)
unnamed: Q2.G, R4.2
unnamed: D4.C (A), Q2.D, SOL2.2
unnamed: NEO6.4-DIN (DI), NEO10.2-DOUT (DO)
unnamed: NEO6.2-DOUT (DO), NEO7.4-DIN (DI)
unnamed: Q1.G, R1.2
unnamed: D1.C (A), Q1.D, SOL1.2
NEO1_OUT: JP1.3, NEO7.2-DOUT (DO)
NEO_OUT: JP1.2, NEO_2A1.2
NEO_PIX1: R5.2, U$1.5 (5/PWM)
NEO_PIX2: JP1.1, P1.5, U$1.10 (10/TX2/PWM)
NOUT: P1.4
POT1: POT1.2, U$1.17/A3 (17/A3/T)
POT2: POT2.2, U$1.15/A1 (15/A1/T)
SCL0: P1.7, R11.1, U2.2 (SCL), U$1.19/A5 (19/A5/T/SCL0), VMEL1.5 (SCL), VMEL2.5 (SCL)
SDA0: P1.6, R10.1, U2.3 (SDA), U$1.18/A4 (18/A4/T/SDA0), VMEL1.2 (SDA), VMEL2.2 (SDA)
SOL1: R1.1, U$1.3 (3/CAN-TX/PWM)
SOL2: R4.1, U$1.7 (7/RX3)

Notes on the sheet:
Neo Pixels
I2C
Solenoids and Motors
Teensy 3.2 + Audio Board
Power
Make sure this cap is placed with correct polarity
CTRL
add fault for the motor driver
LDRs are not connected!!!!!!
Add decoupling caps for teensy
Perhaps replace the JST ph connectors for the microphone boards to the onboard footprints
make a single connector to the eye-stock
10R
First (left) microphone should be connected to GND Second (right) microphone should be connected to 3.3V
C1 and C2 need to be placed as close as possible to the mic C1 should be the closest
Pull-up resistors for SDA and SCL are included in the microcontroller design block
C1 needs to be as close as possible to the sensor
Any copper in the immediate proximity of the sensor which is not needed must to be removed (including ground pours and traces)
NeoP1 is for the onboard neo's
Neo2 is for external neopixels
TODO - add jumper which allows for neop connector to switch between Neo1 and Neo2
DOUBLE CHECK POLARITY OF DIODES
