nathanshaw/Parrot/pcb/small_pcb_v1/small_pcb_explorator_58mm_lyre_v1_1.brd

## EAGLE design pcb/small_pcb_v1/small_pcb_explorator_58mm_lyre_v1_1.brd (continued)

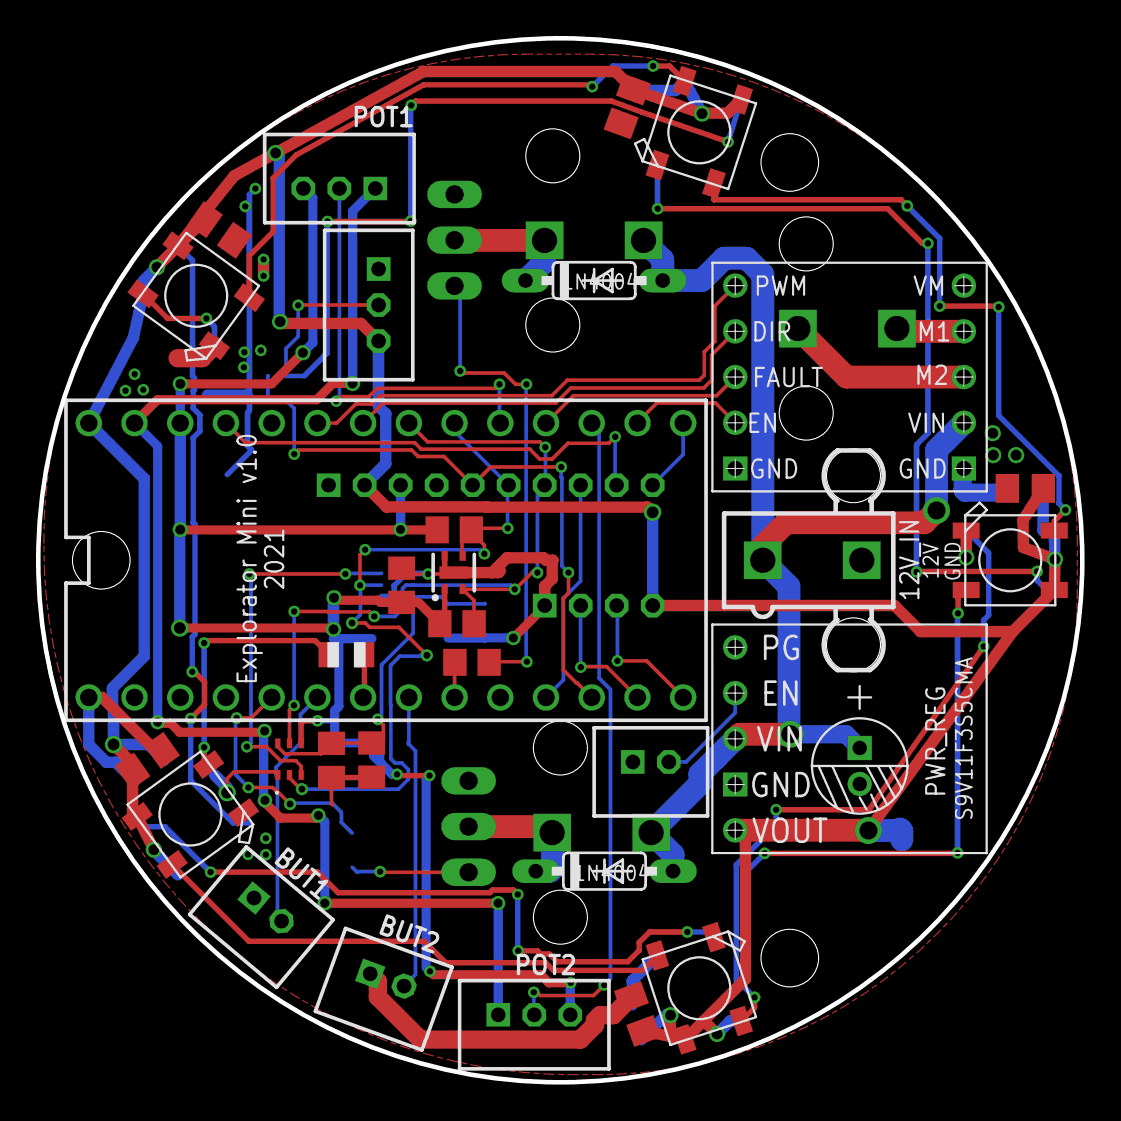
[picture p25: board small_pcb_explorator_58mm_lyre_v1_1.brd from above]

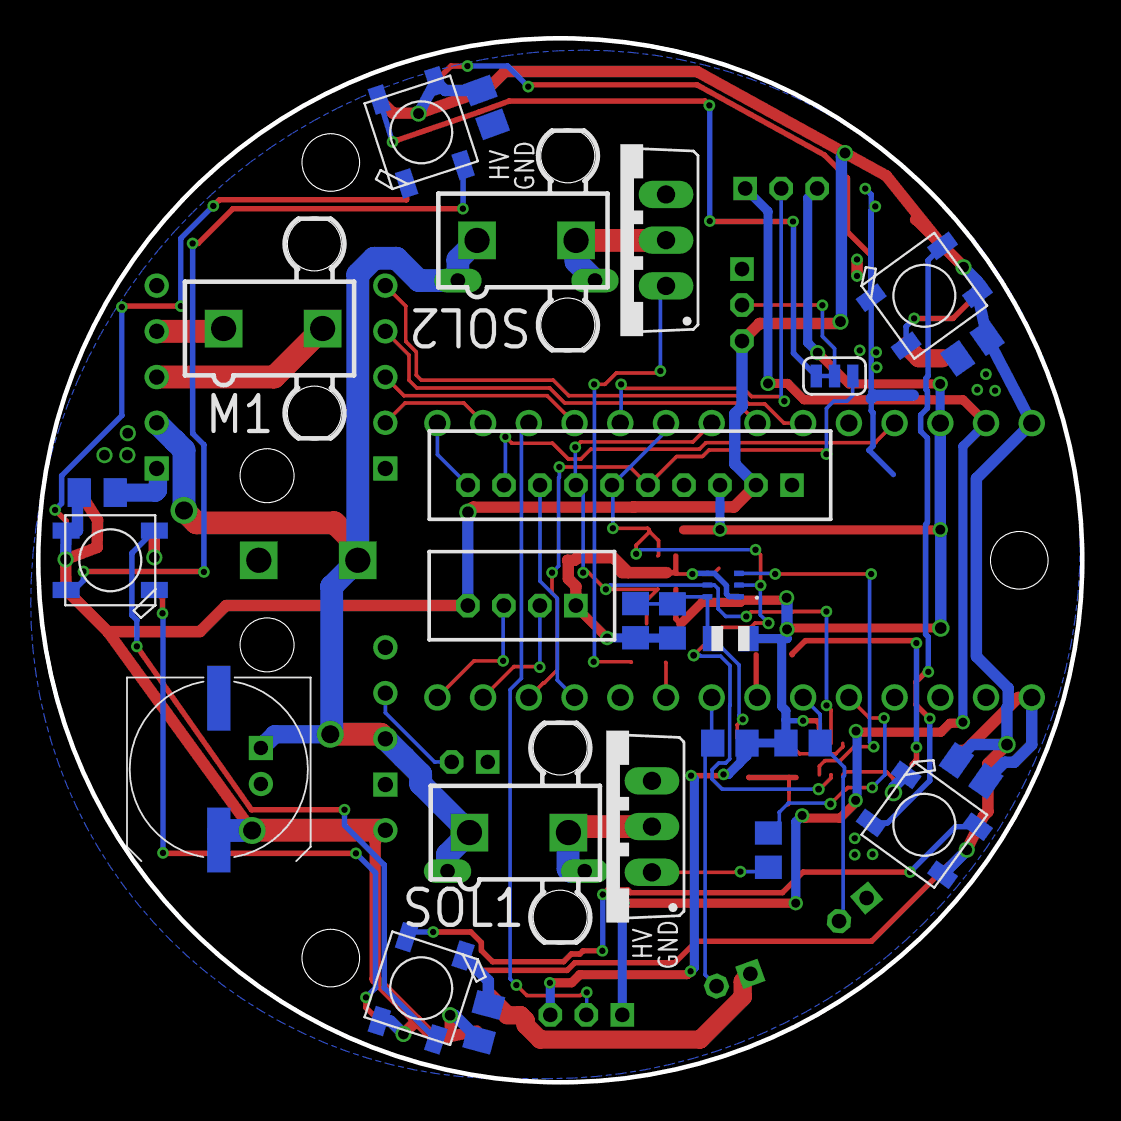
[picture p26: board small_pcb_explorator_58mm_lyre_v1_1.brd from below]

Board: 2 copper layers, 58.0 x 58.0 mm, 58 parts (26 on the bottom side), 45 nets.
