nathanshaw/Parrot/pcb/v0_2/parrot_v2.brd

## EAGLE design pcb/v0_2/parrot_v2.brd (2021-03-06, an earlier design)

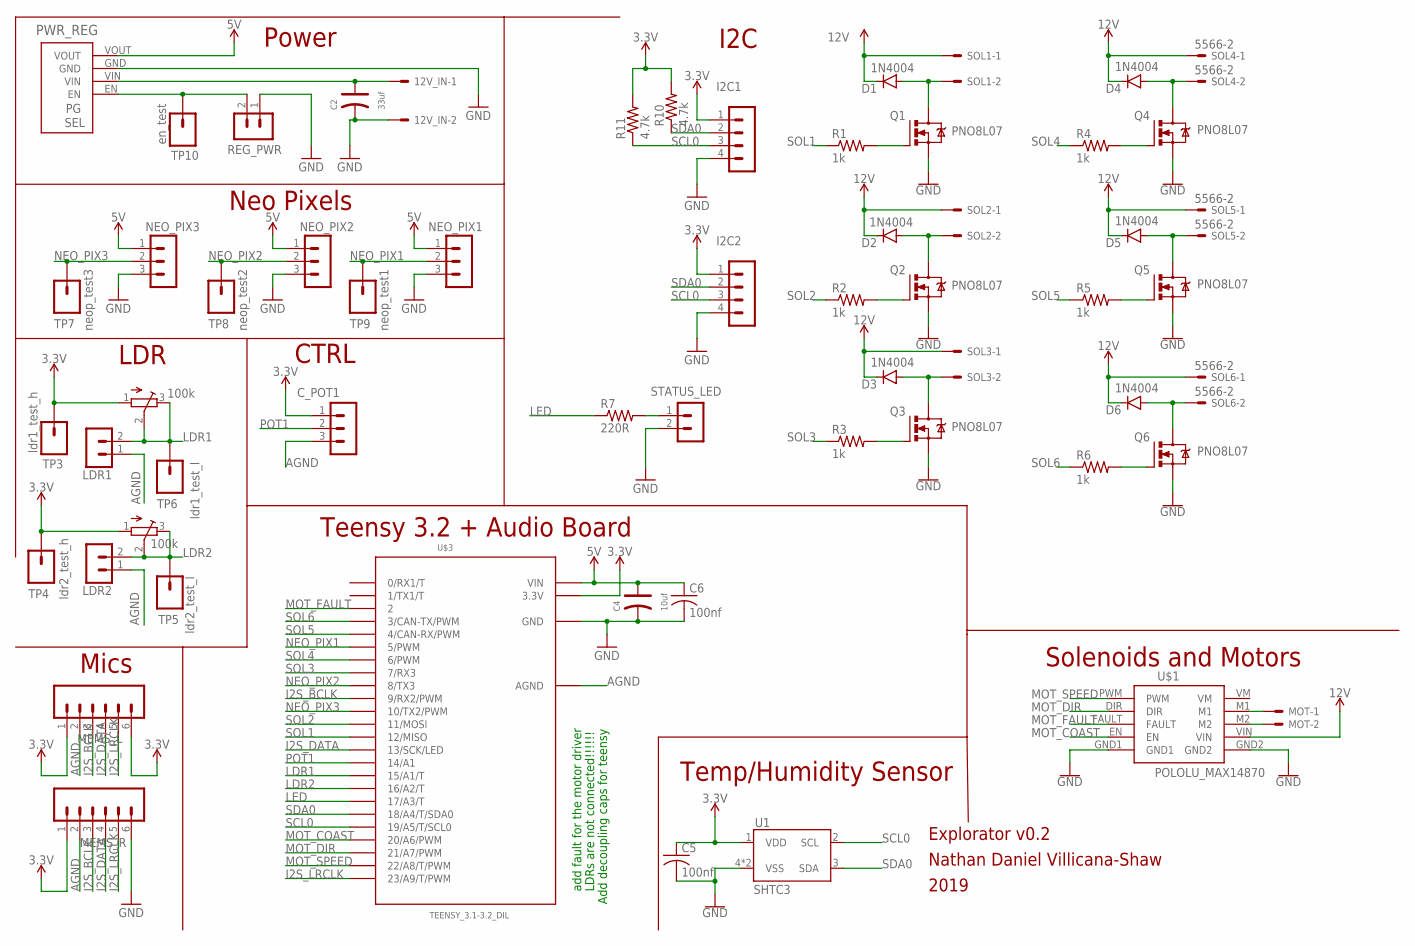
[picture p27: schematic parrot_v2.sch]

Parts:
12V_IN: 5566-2
C2: 33uf; PC-D5.3MM
C4: 10uf; PC-D5.3MM
C5, C6: 100nf; C2012
C_POT1: B3B-PH-K
D1, D2, D3, D4, D5, D6: 1N4004; DIODE-1N4001
I2C1, I2C2: B4B-PH-K
LDR1, LDR2: B2B-PH-K
MEMS_L: CONN_06POLAR; MOLEX-1X6
MEMS_R: CONN_06POLAR; MOLEX-1X6
MOT: 5566-2
NEO_PIX1, NEO_PIX2, NEO_PIX3: B3B-PH-K
PWR_REG: S9V11F5S6CMA_MISSINIG_PINS; S9V11F3S5CMA_MISSING_PINS
Q1, Q2, Q3, Q4, Q5, Q6: PNO8L07; TO220BV
R1, R2, R3, R4, R5, R6: 1k; M1206
R7: 220R; M1206
R10, R11: 4.7k; M1206
REG_PWR: B2B-PH-K
SOL1, SOL2, SOL3, SOL4, SOL5, SOL6: 5566-2
STATUS_LED: B2B-PH-K
TM1, TM2: 100k; TC33X
TP3: ldr1_test_h; 1X01
TP4: ldr2_test_h; 1X01
TP5: ldr2_test_l; 1X01
TP6: ldr1_test_l; 1X01
TP7: neop_test3; 1X01
TP8: neop_test2; 1X01
TP9: neop_test1; 1X01
TP10: en_test; 1X01
U1: SHTC3
U$1: POLOLU_MAX14870
U$3: TEENSY_3.1-3.2_DIL; TEENSY_3.0-3.2&LC_DIL

Connections:
3.3V: C5.1, C_POT1.1, I2C1.1, I2C2.1, MEMS_L.1, MEMS_L.6, MEMS_R.1, R10.2, R11.2, TM1.1 (A), TM2.1 (A), TP3.1, TP4.1, U1.1 (VDD), U$3.3.3V
5V: C4.+, C6.1, NEO_PIX1.1, NEO_PIX2.1, NEO_PIX3.1, PWR_REG.VOUT, U$3.VIN
12V: 12V_IN.1, C2.+, D1.C, D2.C, D3.C, D4.C, D5.C, D6.C, PWR_REG.VIN, SOL1.1, SOL2.1, SOL3.1, SOL4.1, SOL5.1, SOL6.1, U$1.VIN
AGND: C_POT1.3, LDR1.1, LDR2.1, MEMS_L.2, MEMS_R.2, U$3.AGND
GND: 12V_IN.2, C2.-, C4.-, C5.2, C6.2, I2C1.4, I2C2.4, MEMS_R.6, NEO_PIX1.3, NEO_PIX2.3, NEO_PIX3.3, PWR_REG.GND, Q1.S, Q2.S, Q3.S, Q4.S, Q5.S, Q6.S, REG_PWR.1, STATUS_LED.2, U1.4 (VSS), U1.5 (VSS), U$1.GND1, U$1.GND2, U$3.GND
I2S_BCLK: MEMS_L.3, MEMS_R.3, U$3.9 (9/RX2/PWM)
I2S_DATA: MEMS_L.4, MEMS_R.4, U$3.13 (13/SCK/LED)
I2S_LRCLK: MEMS_L.5, MEMS_R.5, U$3.23/A9 (23/A9/T/PWM)
LDR1: LDR1.2, TM1.2 (S), TM1.3 (E), TP6.1, U$3.15/A1 (15/A1/T)
LDR2: LDR2.2, TM2.2 (S), TM2.3 (E), TP5.1, U$3.16/A2 (16/A2/T)
LED: R7.1, U$3.17/A3 (17/A3/T)
MOT_COAST: U$1.EN, U$3.20/A6 (20/A6/PWM)
MOT_DIR: U$1.DIR, U$3.21/A7 (21/A7/PWM)
MOT_FAULT: U$1.FAULT, U$3.2
MOT_SPEED: U$1.PWM, U$3.22/A8 (22/A8/T/PWM)
unnamed: Q5.G, R5.2
unnamed: D5.A, Q5.D, SOL5.2
unnamed: Q6.G, R6.2
unnamed: Q2.G, R2.2
unnamed: D6.A, Q6.D, SOL6.2
unnamed: R7.2, STATUS_LED.1
unnamed: D2.A, Q2.D, SOL2.2
unnamed: PWR_REG.EN, REG_PWR.2, TP10.1
unnamed: Q3.G, R3.2
unnamed: D3.A, Q3.D, SOL3.2
unnamed: Q4.G, R4.2
unnamed: D4.A, Q4.D, SOL4.2
unnamed: Q1.G, R1.2
unnamed: D1.A, Q1.D, SOL1.2
unnamed: MOT.2, U$1.M2
unnamed: MOT.1, U$1.M1
NEO_PIX1: NEO_PIX1.2, TP9.1, U$3.5 (5/PWM)
NEO_PIX2: NEO_PIX2.2, TP8.1, U$3.8 (8/TX3)
NEO_PIX3: NEO_PIX3.2, TP7.1, U$3.10 (10/TX2/PWM)
POT1: C_POT1.2, U$3.14/A0 (14/A1)
SCL0: I2C1.3, I2C2.3, R11.1, U1.2 (SCL), U$3.19/A5 (19/A5/T/SCL0)
SDA0: I2C1.2, I2C2.2, R10.1, U1.3 (SDA), U$3.18/A4 (18/A4/T/SDA0)
SOL1: R1.1, U$3.12 (12/MISO)
SOL2: R2.1, U$3.11 (11/MOSI)
SOL3: R3.1, U$3.7 (7/RX3)
SOL4: R4.1, U$3.6 (6/PWM)
SOL5: R5.1, U$3.4 (4/CAN-RX/PWM)
SOL6: R6.1, U$3.3 (3/CAN-TX/PWM)

Notes on the sheet:
Neo Pixels
LDR
I2C
Solenoids and Motors
Teensy 3.2 + Audio Board
Mics
Power
Temp/Humidity Sensor
CTRL
add fault for the motor driver
LDRs are not connected!!!!!!
Add decoupling caps for teensy
Explorator v0.2
Nathan Daniel Villicana-Shaw
2019

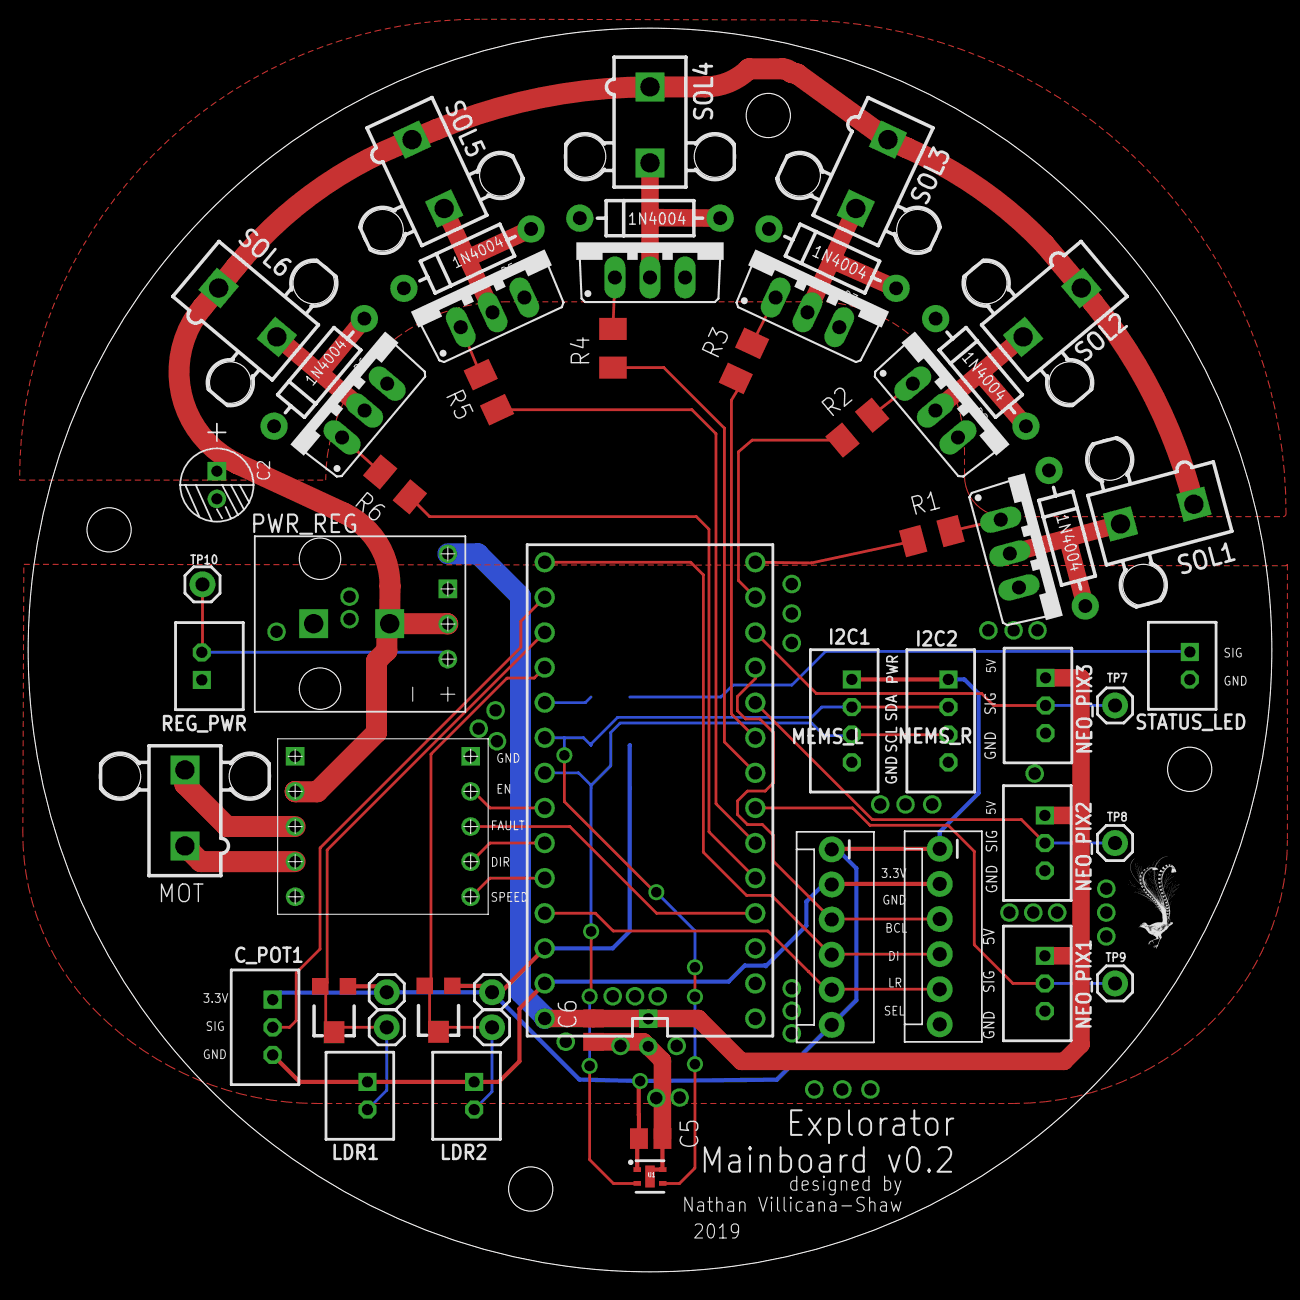
[picture p28: board parrot_v2.brd from above]

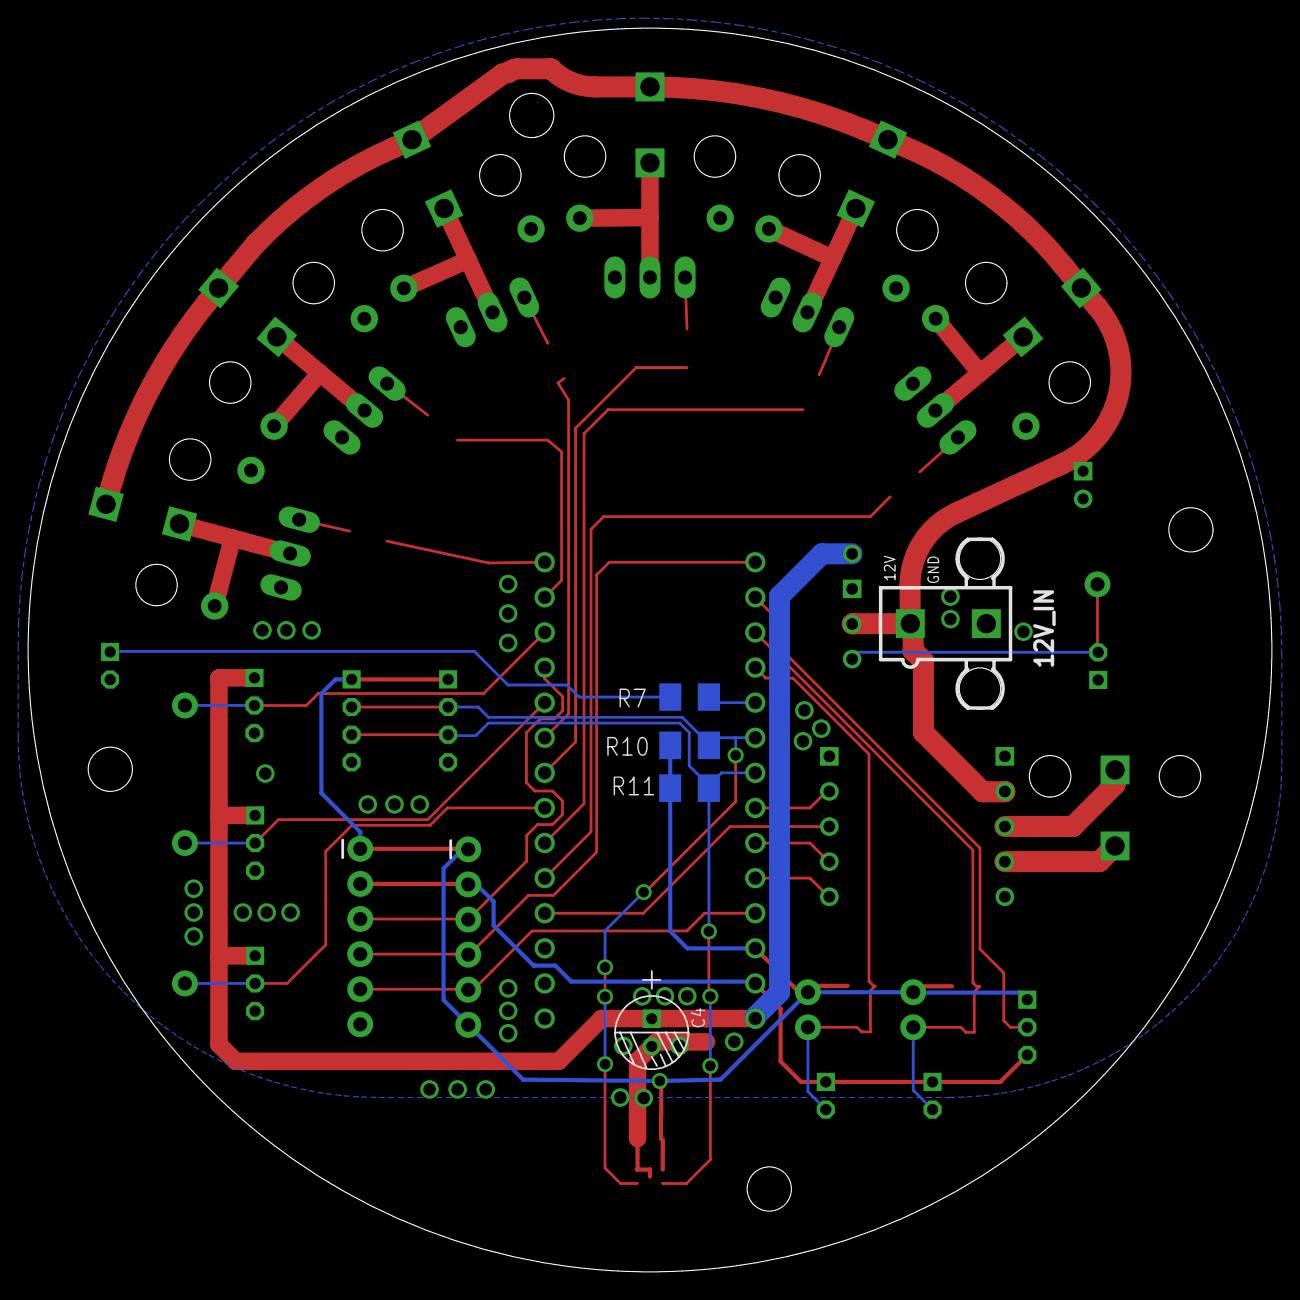
[picture p29: board parrot_v2.brd from below]

Board: 2 copper layers, 90.0 x 90.0 mm, 59 parts (5 on the bottom side), 43 nets.
