nathanshaw/Parrot/legacy/pcb/v1.1/parrot_v1.1.brd

## EAGLE design legacy/pcb/v1.1/parrot_v1.1.brd (2019-10-18, an earlier design)

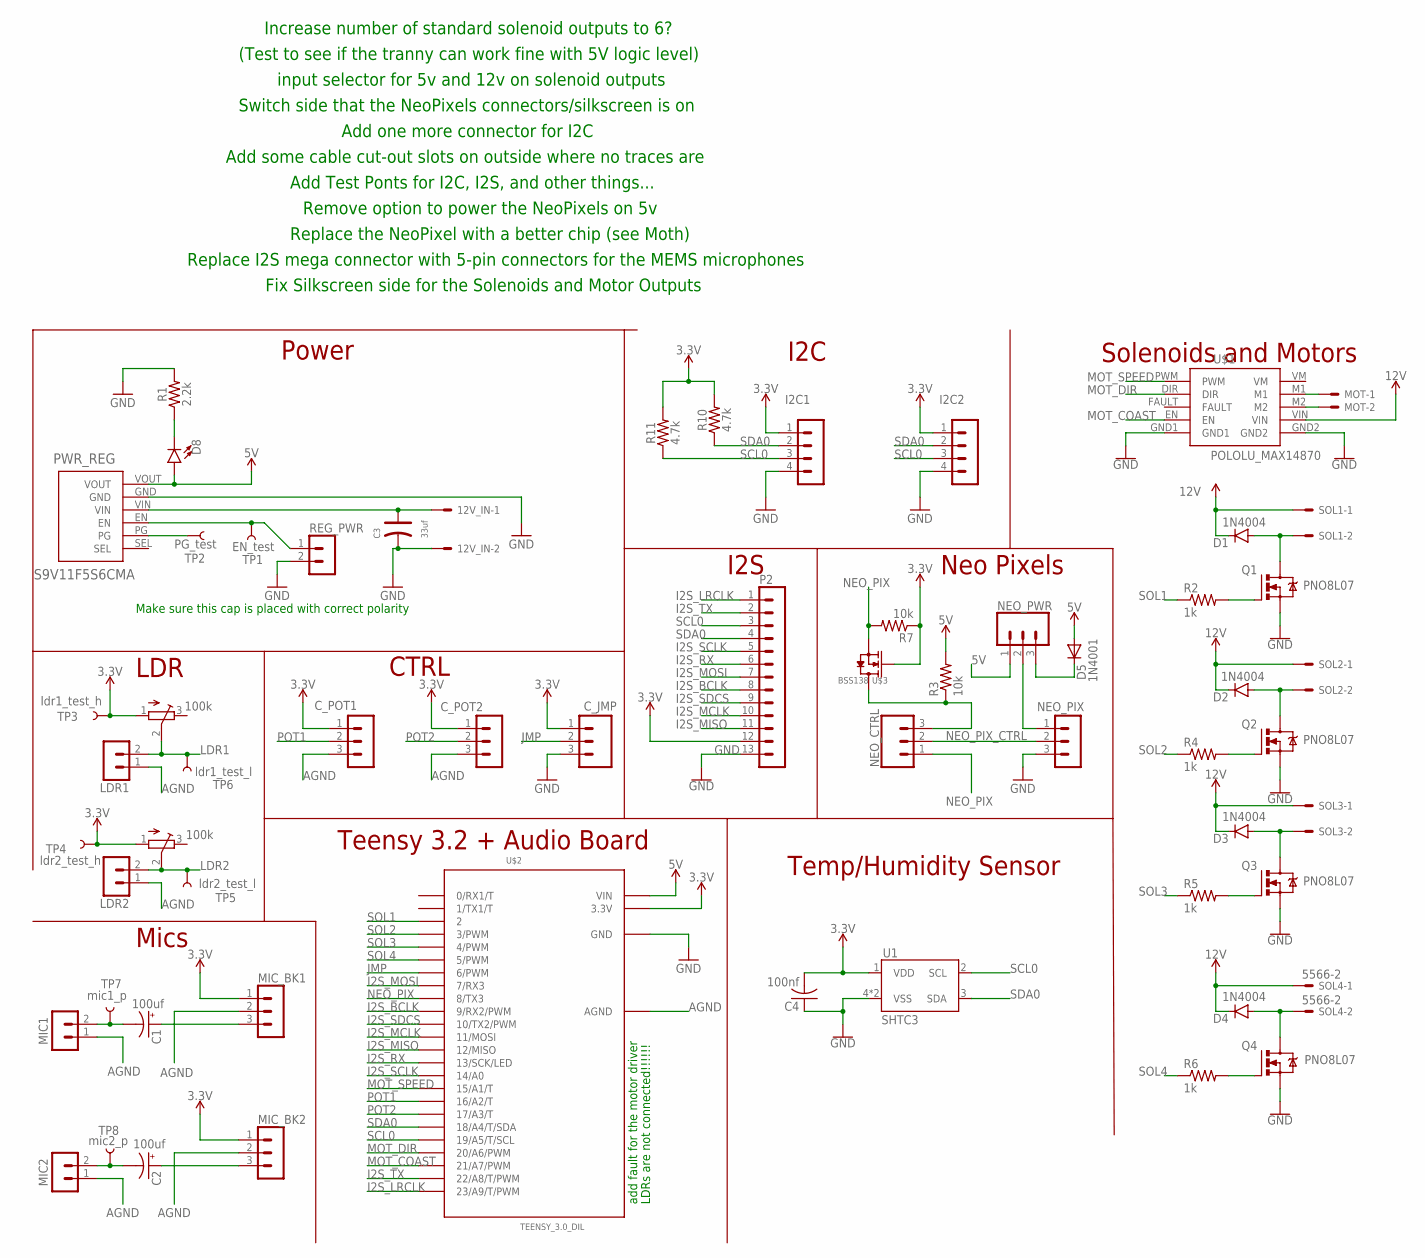
[picture p30: schematic parrot_v1.1.sch]

Parts:
12V_IN: 5566-2
C1, C2: 100uf; CPOL-RADIAL-5MM-10MM
C3: 33uf; PC-D5.3MM
C4: 100nf; C2012
C_JMP: CONN_03; 1X03
C_POT1, C_POT2: B3B-PH-K
D1, D2, D3, D4: 1N4004; DIODE-1N4001
D5: 1N4001; DO41-10
D8: LED-FKIT-1206; FKIT-LED-1206
I2C1, I2C2: B4B-PH-K
LDR1, LDR2: B2B-PH-K
MIC1, MIC2: B2B-PH-K
MIC_BK1, MIC_BK2: B3B-PH-K
MOT: 5566-2
NEO_CTRL: CONN_03; 1X03
NEO_PIX: B3B-PH-K
NEO_PWR: CONN_03; 1X03
P2: B13B-PH-K
PWR_REG: S9V11F5S6CMA; S9V11F3S5CMA
Q1, Q2, Q3, Q4: PNO8L07; TO220BV
R1: 2.2k; 0603
R2, R4, R5, R6: 1k; AXIAL-0.3
R3, R7: 10k; AXIAL-0.3
R10, R11: 4.7k; AXIAL-0.3
REG_PWR: B2B-PH-K
SOL1, SOL2, SOL3, SOL4: 5566-2
TM1, TM2: 100k; TC33X
TP1: EN_test; TP_15TH
TP2: PG_test; TP_15TH
TP3: ldr1_test_h; TP_15TH
TP4: ldr2_test_h; TP_15TH
TP5: ldr2_test_l; TP_15TH
TP6: ldr1_test_l; TP_15TH
TP7: mic1_p; TP_15TH
TP8: mic2_p; TP_15TH
U1: SHTC3
U$1: POLOLU_MAX14870
U$2: TEENSY_3.0_DIL; TEENSY_3.0-3.2&LC_DIL
U$3: BSS138; SOT23-3

Connections:
3.3V: C4.2, C_JMP.1, C_POT1.1, C_POT2.1, I2C1.1, I2C2.1, MIC_BK1.1, MIC_BK2.1, P2.12, R7.P$1 (1), R10.P$2 (2), R11.P$2 (2), TM1.1 (A), TM2.1 (A), TP3.P$1, TP4.P$1, U1.1 (VDD), U$2.3.3V, U$3.1 (G)
5V: D5.A, D8.A, NEO_PWR.1, PWR_REG.VOUT, R3.P$2 (2), U$2.VIN
12V: 12V_IN.1, C3.+, D1.C, D2.C, D3.C, D4.C, PWR_REG.VIN, SOL1.1, SOL2.1, SOL3.1, SOL4.1, U$1.VIN
AGND: C_POT1.3, C_POT2.3, LDR1.1, LDR2.1, MIC1.1, MIC2.1, MIC_BK1.2, MIC_BK2.2, U$2.AGND
GND: 12V_IN.2, C3.-, C4.1, C_JMP.3, I2C1.4, I2C2.4, NEO_PIX.3, P2.13, PWR_REG.GND, Q1.S, Q2.S, Q3.S, Q4.S, R1.2, REG_PWR.2, U1.4 (VSS), U1.5 (VSS), U$1.GND2, U$2.GND
I2S_BCLK: P2.8, U$2.9 (9/RX2/PWM)
I2S_LRCLK: P2.1, U$2.23/A9 (23/A9/T/PWM)
I2S_MCLK: P2.10, U$2.11 (11/MOSI)
I2S_MISO: P2.11, U$2.12 (12/MISO)
I2S_MOSI: P2.7, U$2.7 (7/RX3)
I2S_RX: P2.6, U$2.13 (13/SCK/LED)
I2S_SCLK: P2.5, U$2.14/A0
I2S_SDCS: P2.9, U$2.10 (10/TX2/PWM)
I2S_TX: P2.2, U$2.22/A8 (22/A8/T/PWM)
JMP: C_JMP.2, U$2.6 (6/PWM)
LDR1: LDR1.2, TM1.2 (S), TP6.P$1
LDR2: LDR2.2, TM2.2 (S), TP5.P$1
MOT_COAST: U$1.EN, U$2.21/A7 (21/A7/PWM)
MOT_DIR: U$1.DIR, U$2.20/A6 (20/A6/PWM)
MOT_SPEED: U$1.PWM, U$2.15/A1 (15/A1/T)
unnamed: D8.C, R1.1
unnamed: C1.-, MIC1.2, TP7.P$1
unnamed: PWR_REG.PG, TP2.P$1
unnamed: C2.+, MIC_BK2.3
unnamed: Q2.G, R4.P$2 (2)
unnamed: C1.+, MIC_BK1.3
unnamed: C2.-, MIC2.2, TP8.P$1
unnamed: D2.A, Q2.D, SOL2.2
unnamed: NEO_PIX.1, NEO_PWR.2
unnamed: PWR_REG.EN, REG_PWR.1, TP1.P$1
unnamed: Q3.G, R5.P$2 (2)
unnamed: D3.A, Q3.D, SOL3.2
unnamed: Q4.G, R6.P$2 (2)
unnamed: D4.A, Q4.D, SOL4.2
unnamed: D5.C, NEO_PWR.3
unnamed: NEO_CTRL.3, R3.P$1 (1), U$3.3 (D)
unnamed: Q1.G, R2.P$2 (2)
unnamed: D1.A, Q1.D, SOL1.2
unnamed: MOT.2, U$1.M2
unnamed: MOT.1, U$1.M1
NEO_PIX: NEO_CTRL.1, R7.P$2 (2), U$2.8 (8/TX3), U$3.2 (S)
NEO_PIX_CTRL: NEO_CTRL.2, NEO_PIX.2
POT1: C_POT1.2, U$2.16/A2 (16/A2/T)
POT2: C_POT2.2, U$2.17/A3 (17/A3/T)
SCL0: I2C1.3, I2C2.3, P2.3, R11.P$1 (1), U1.2 (SCL), U$2.19/A5 (19/A5/T/SCL)
SDA0: I2C1.2, I2C2.2, P2.4, R10.P$1 (1), U1.3 (SDA), U$2.18/A4 (18/A4/T/SDA)
SOL1: R2.P$1 (1), U$2.2
SOL2: R4.P$1 (1), U$2.3 (3/PWM)
SOL3: R5.P$1 (1), U$2.4 (4/PWM)
SOL4: R6.P$1 (1), U$2.5 (5/PWM)

Notes on the sheet:
Neo Pixels
LDR
I2C
Solenoids and Motors
Teensy 3.2 + Audio Board
Mics
Power
Make sure this cap is placed with correct polarity
Temp/Humidity Sensor
I2S
CTRL
add fault for the motor driver
LDRs are not connected!!!!!!
Fix Silkscreen side for the Solenoids and Motor Outputs
Replace I2S mega connector with 5-pin connectors for the MEMS microphones
Replace the NeoPixel with a better chip (see Moth)
Remove option to power the NeoPixels on 5v
Add Test Ponts for I2C, I2S, and other things...
Add some cable cut-out slots on outside where no traces are
Add one more connector for I2C
Switch side that the NeoPixels connectors/silkscreen is on
input selector for 5v and 12v on solenoid outputs
(Test to see if the tranny can work fine with 5V logic level)
Increase number of standard solenoid outputs to 6?

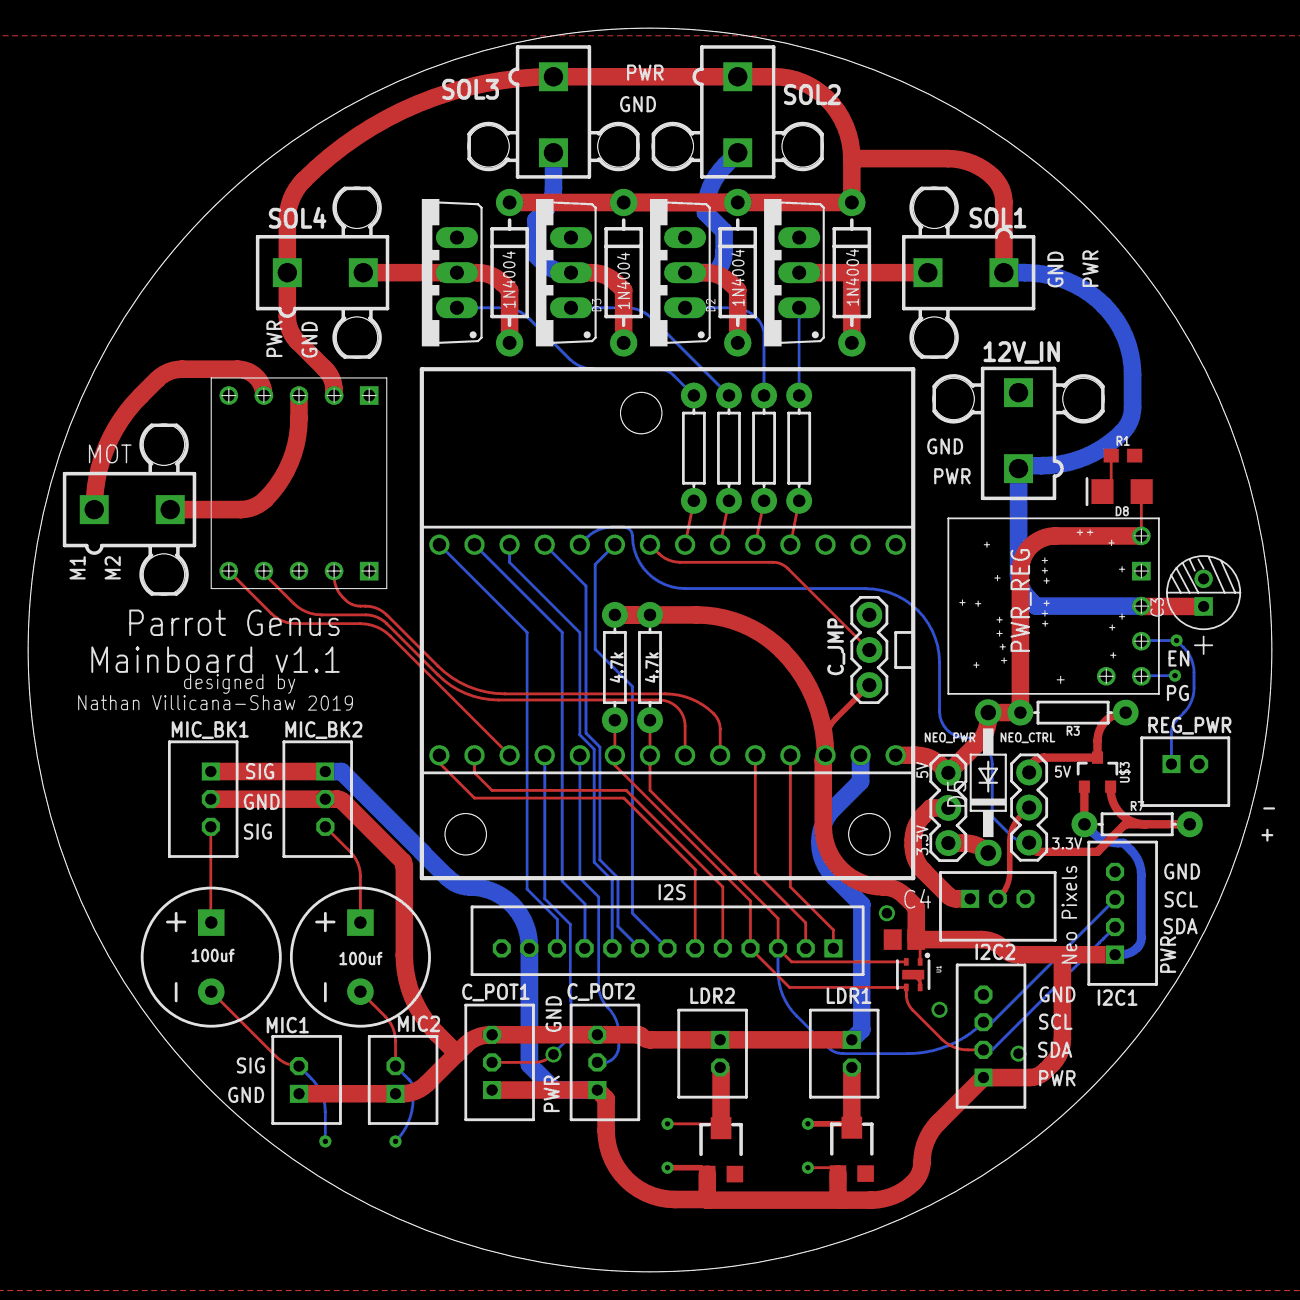
[picture p31: board parrot_v1.1.brd from above]

Board: 2 copper layers, 90.0 x 90.0 mm, 60 parts (0 on the bottom side), 50 nets.
