nathanshaw/Parrot/(commit log)

2019-10-18 added images, zip files and audio tracks to lfs, moved the PCB files into the repo, made a folder for v1 and v2
    [parrot_v1.1.brd, parrot_v1.1.sch, parrot_v1.brd, parrot_v1.sch, parrot_v2.brd, parrot_v2.sch]
2019-10-19 updated the temp/humidity sensor library and test code being used, moved code which used the old Sparkfun library to a newly created legacy firmware folder
2020-02-04 moving along, added pdf, jpg, and png to git lfs
    [90965A200_TYPE 316 STAINLESS STEEL FLAT WASHER.STEP, 91280A702_MED-STRG ZINC-PLTD STL CAP SCREW - CLASS 8.8.STEP, 94904A106_STAINLESS STEEL TEE NUT INSERT FOR WOOD.STEP, Configuration.h, parrot_v2.brd, parrot_v2.sch, parrot_v2_1.brd, parrot_v2_1.sch]
2020-05-14 got the code for lyre to compile
    [Configuration.h, Configuration_adv.h]
2020-07-26 moved some things around in the repo
    [90965A200_TYPE 316 STAINLESS STEEL FLAT WASHER.STEP, 91280A702_MED-STRG ZINC-PLTD STL CAP SCREW - CLASS 8.8.STEP, 94904A106_STAINLESS STEEL TEE NUT INSERT FOR WOOD.STEP, Configuration.h, Configuration_adv.h, lyre_eye_stocks_40mm_breakout.brd, lyre_eye_stocks_40mm_breakout.sch, lyre_v1.brd]
2020-09-24 moving to a v1
    [Configuration.h, Configuration_adv.h]
2020-09-24 working to v1 again lol
    [Configuration.h, Configuration_adv.h]
2021-03-06 updated some long needed things for the repo
    [18500_pack_v1.brd, 18500_pack_v1.sch, 18650_pack_v1.brd, 18650_pack_v1.sch, 90965A200_TYPE 316 STAINLESS STEEL FLAT WASHER.STEP, 91280A702_MED-STRG ZINC-PLTD STL CAP SCREW - CLASS 8.8.STEP, 94904A106_STAINLESS STEEL TEE NUT INSERT FOR WOOD.STEP, Configuration.h]
