nathanshaw/Parrot/(notices)

Notices in the files:
parts and their libraries:
con-jst-ph: Copyright (C) 2016, Bob Starr
SparkFun-PowerSymbols: Licensing: Creative Commons ShareAlike 4.0 International - https://creativecommons.org/licenses/by-sa/4.0
con-molex-mini-fit: Copyright (C) 2011, Bob Starr
